ALSchwalm/pISO/pcb/README.md

Designed with [KiCad](http://kicad-pcb.org/)

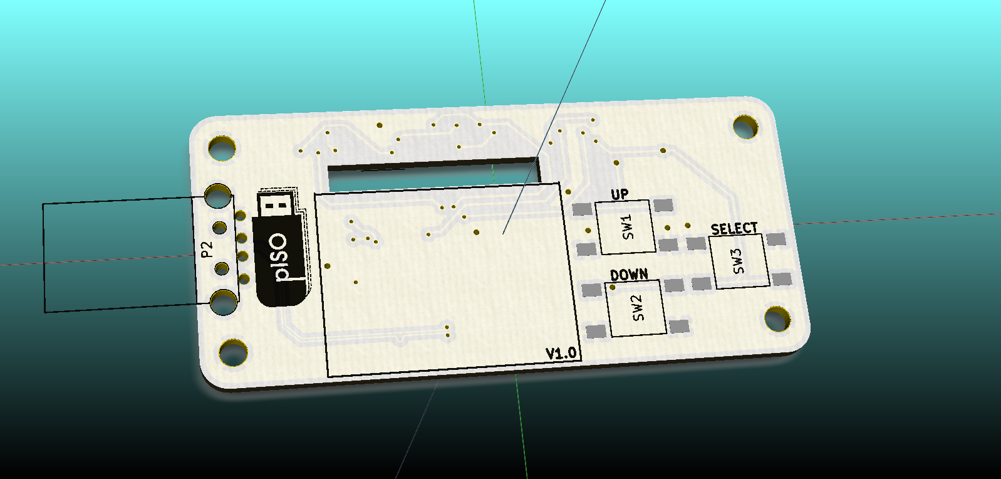
[picture p1: pcb/pHAT/front.png]
front

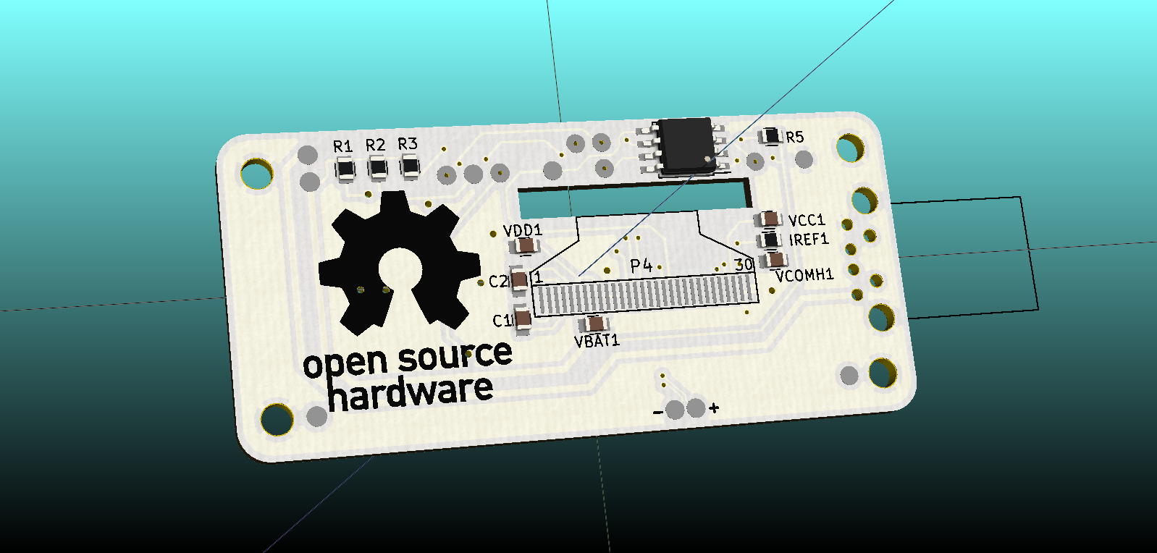
[picture p2: pcb/pHAT/back.png]
back
