ALSchwalm/pISO/pcb/controller_source/readme.txt

Build with atmel studio with -Os

102 chips can be programmed using https://github.com/james-tate/Arduino-TPI-Programmer

25 chips can be programmed over SPI
