ALSchwalm/pISO/assets/create-delete-1.jpg

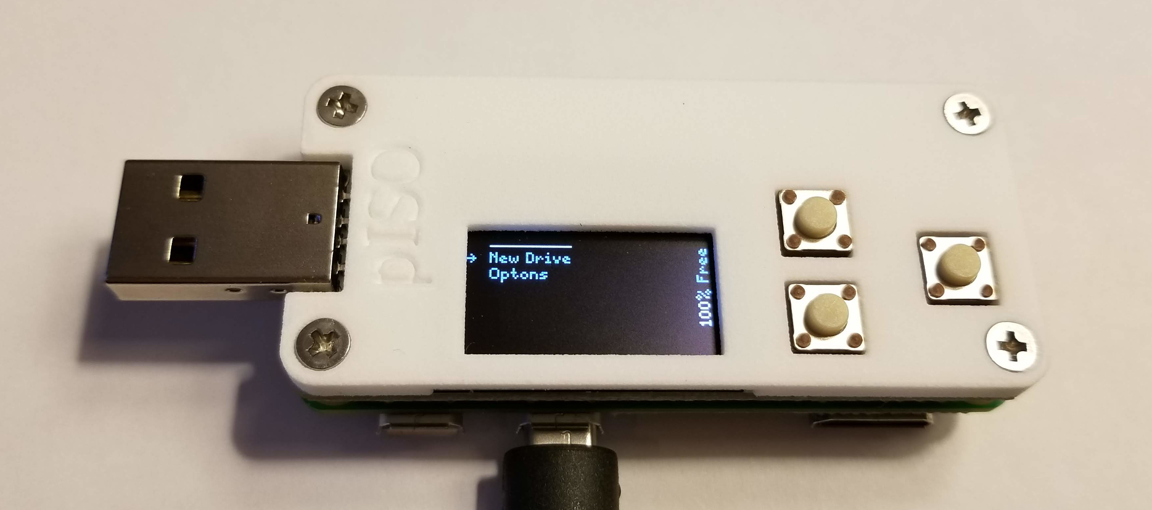
assets/create-delete-1.jpg
