ALSchwalm/pISO/assets/create-delete-2.jpg

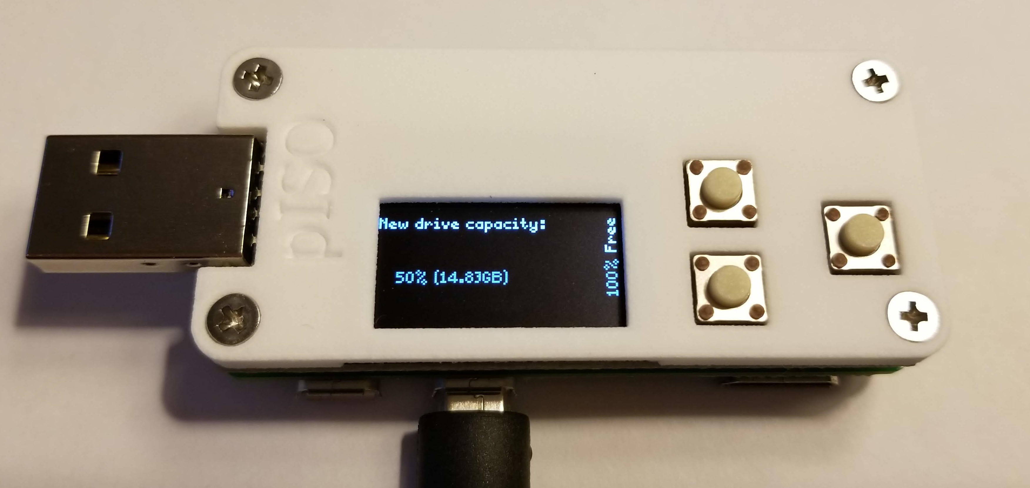
assets/create-delete-2.jpg
