ALSchwalm/pISO/assets/create-delete-3.jpg

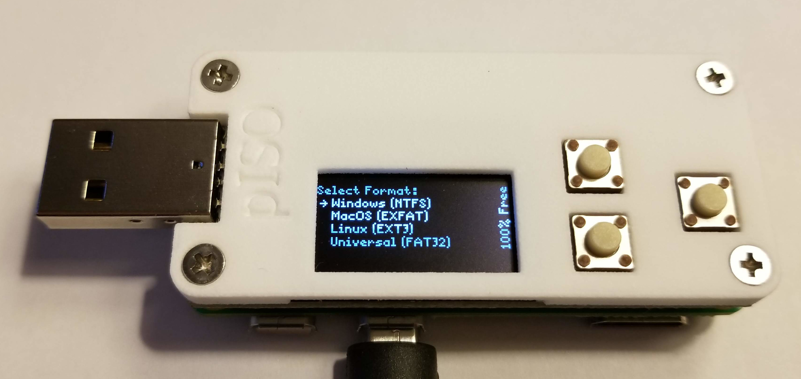
assets/create-delete-3.jpg
