ALSchwalm/pISO/assets/create-delete-5.jpg

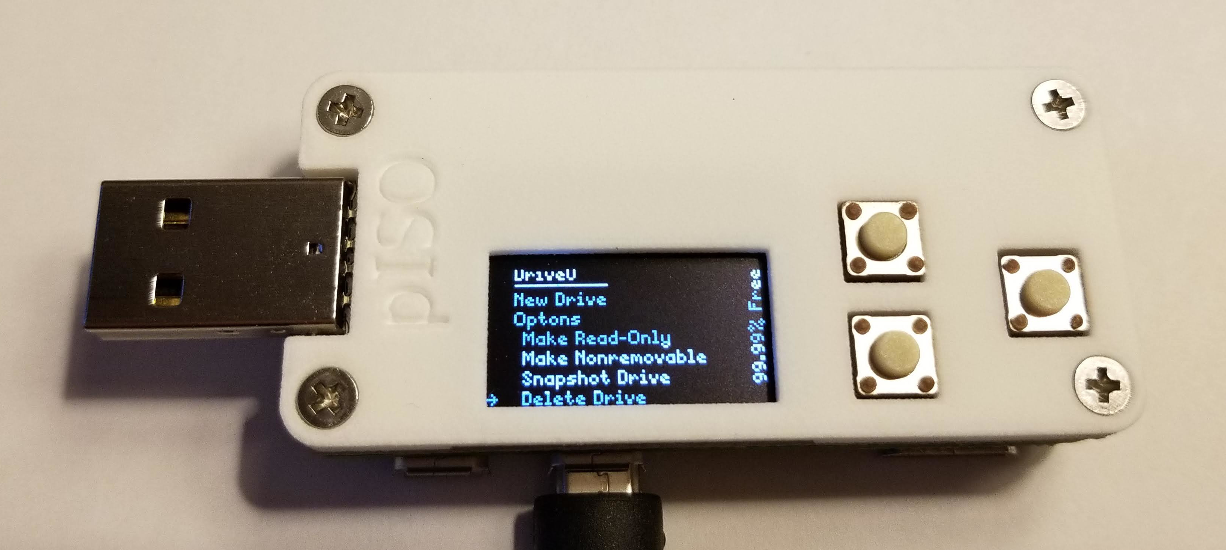
assets/create-delete-5.jpg
