ALSchwalm/pISO/assets/create-delete-6.jpg

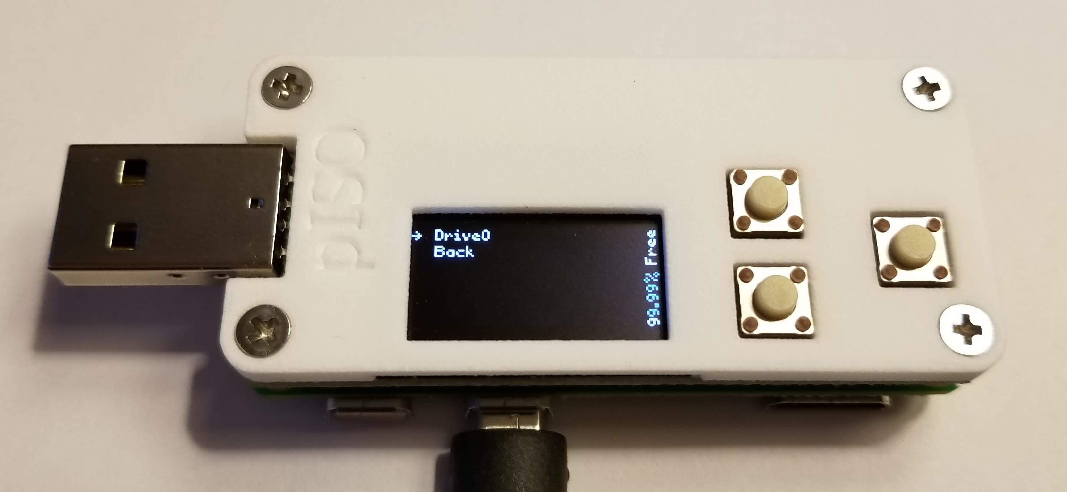
assets/create-delete-6.jpg
