ALSchwalm/pISO/assets/read-only-non-removable-1.jpg

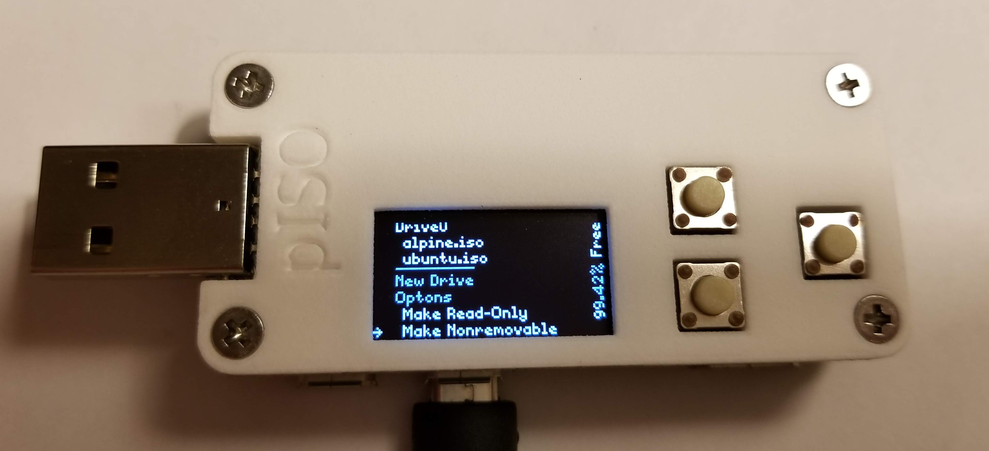
assets/read-only-non-removable-1.jpg
