ALSchwalm/pISO/assets/read-only-non-removable-2.jpg

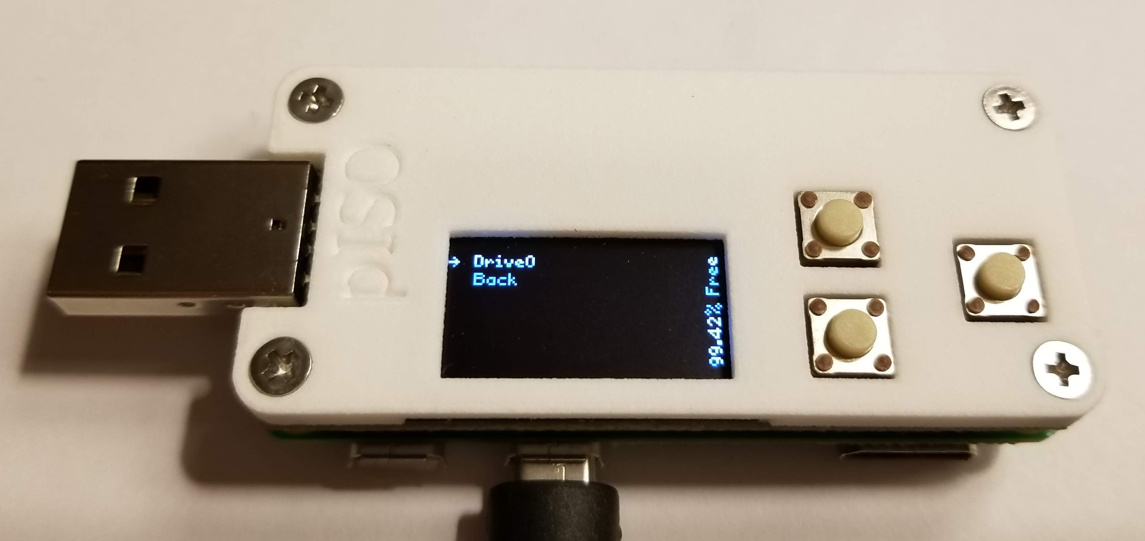
assets/read-only-non-removable-2.jpg
