ALSchwalm/pISO/assets/read-only-non-removable-3.jpg

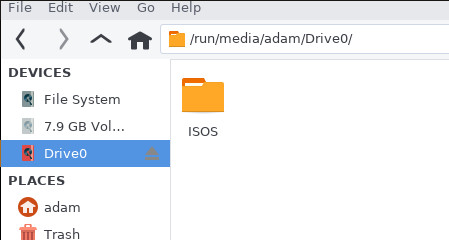
assets/read-only-non-removable-3.jpg
