ALSchwalm/pISO/assets/snapshot-3.jpg

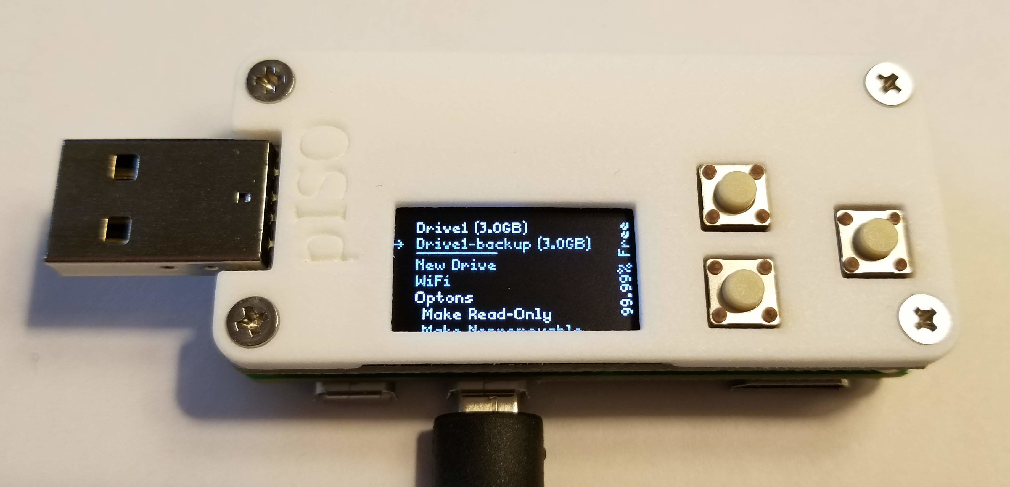
assets/snapshot-3.jpg
