ALSchwalm/pISO/assets/store-and-mount-1.jpg

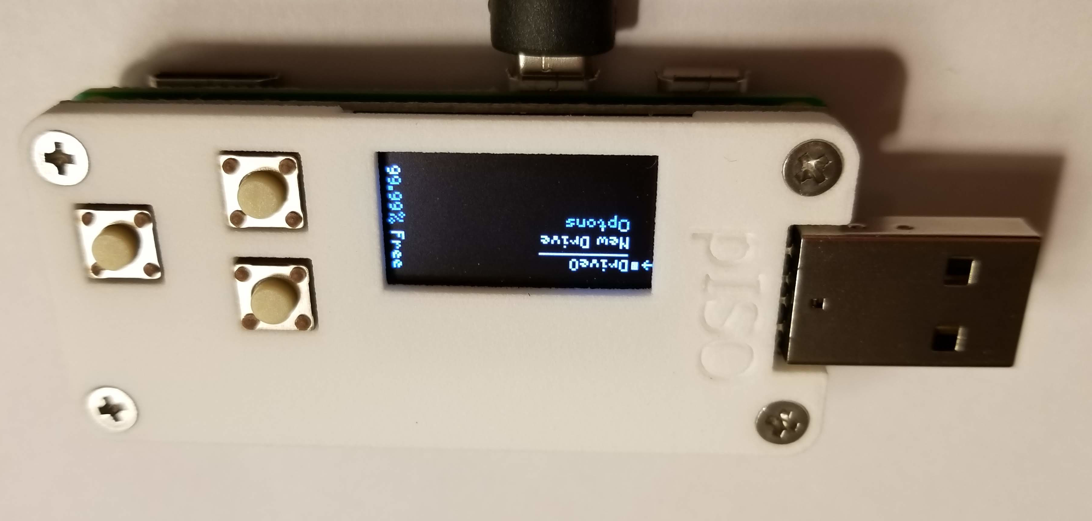
assets/store-and-mount-1.jpg
