ALSchwalm/pISO/assets/store-and-mount-2.jpg

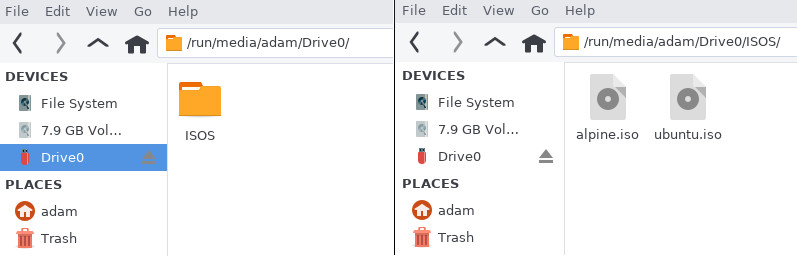
assets/store-and-mount-2.jpg
