ALSchwalm/pISO/assets/store-and-mount-3.jpg

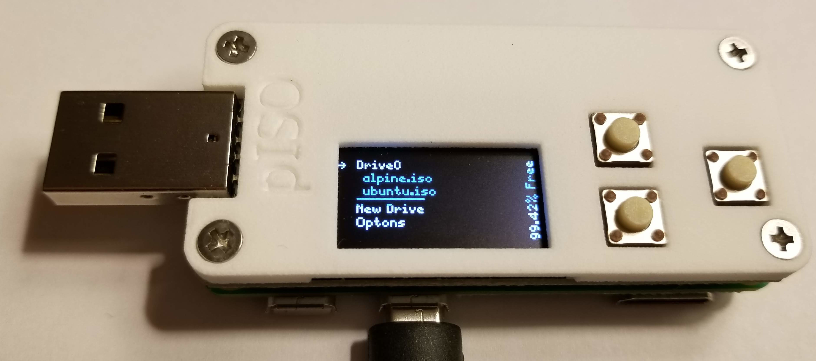
assets/store-and-mount-3.jpg
