ALSchwalm/pISO/assets/store-and-mount-4.jpg

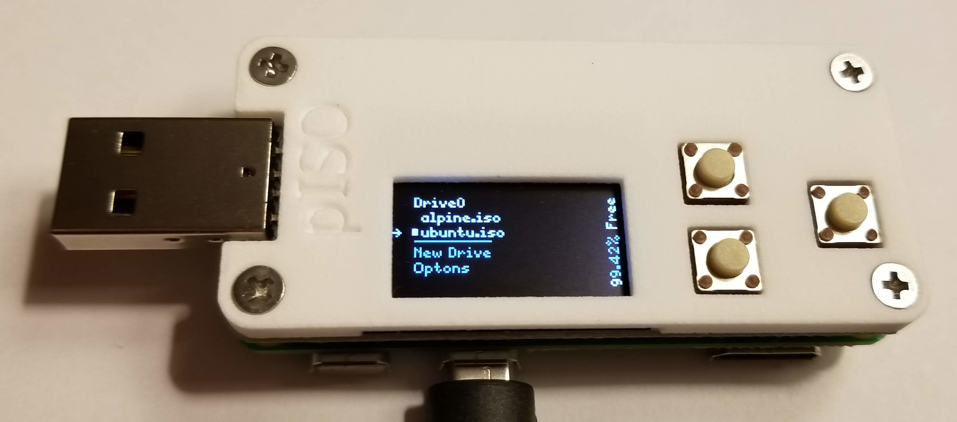
assets/store-and-mount-4.jpg
