ALSchwalm/pISO/assets/store-and-mount-5.jpg

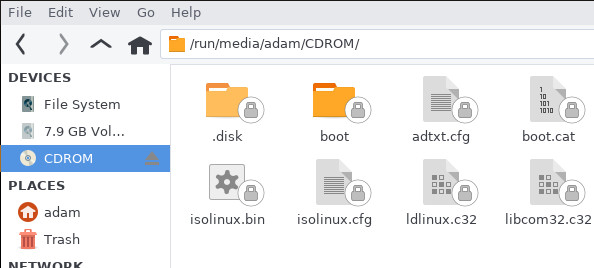
assets/store-and-mount-5.jpg
