ALSchwalm/pISO/assets/wifi-1.jpg

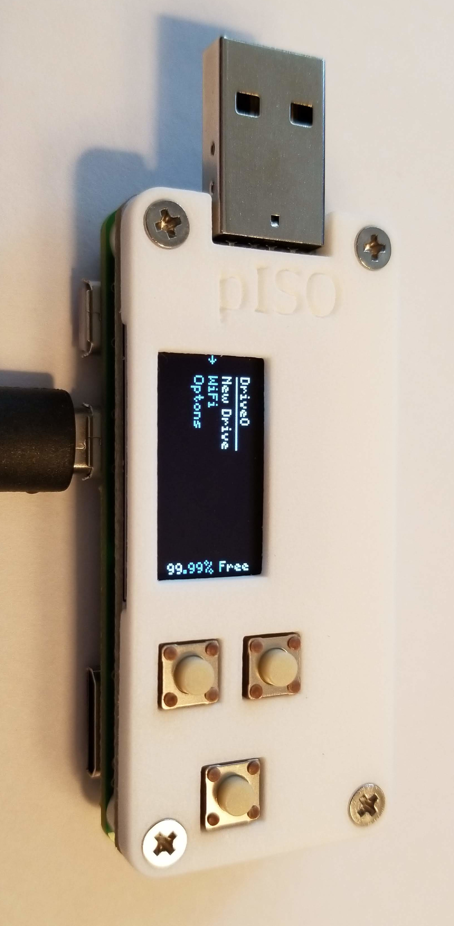
assets/wifi-1.jpg
