ALSchwalm/pISO/assets/wifi-2.jpg

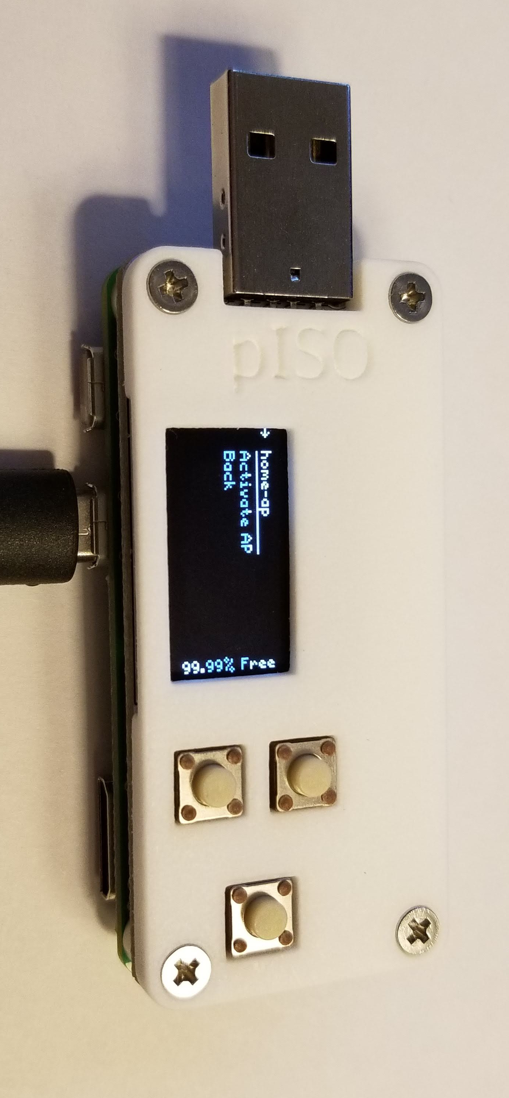
assets/wifi-2.jpg
