ALSchwalm/pISO/assets/wifi-3.jpg

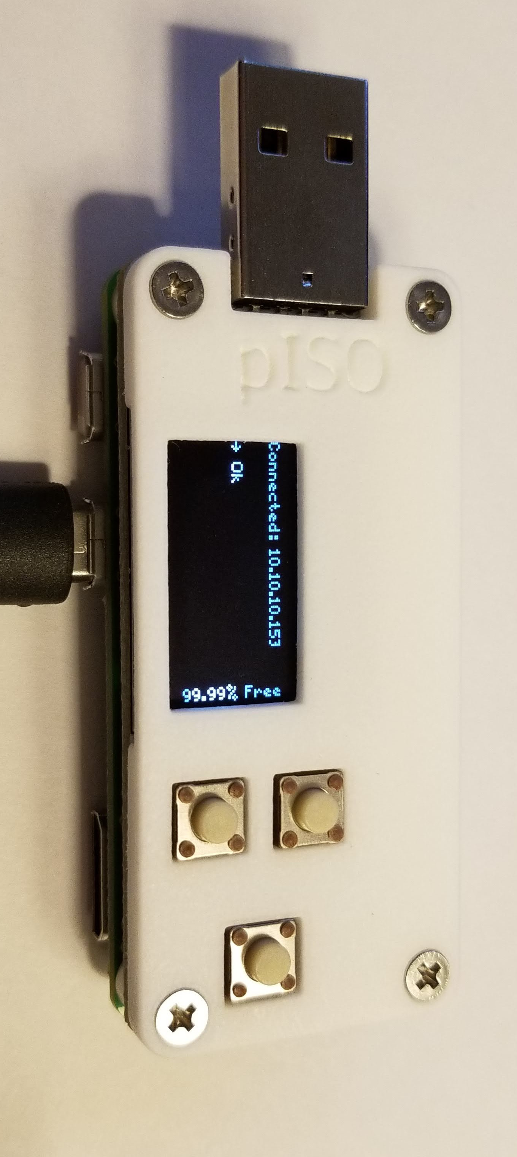
assets/wifi-3.jpg
