ALSchwalm/pISO/assets/wifi-4.jpg

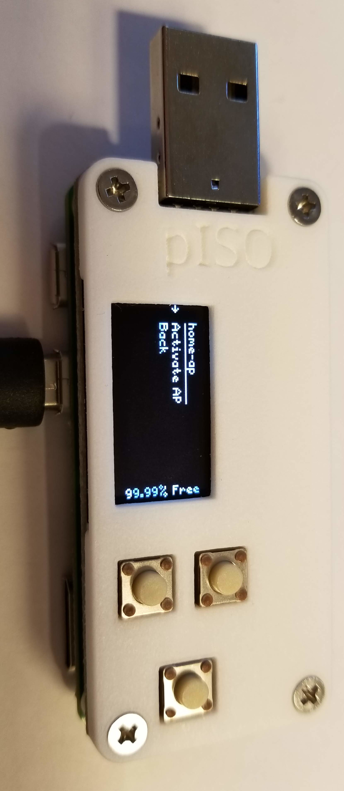
assets/wifi-4.jpg
