ALSchwalm/pISO/pcb/pHAT/BOM/pHAT.xls

Reference | Number Parts | Value | Datasheet
P4 | 1 | CONN_01X30 | http://www.wisechip.com.tw/s/2/product-380039/0-96%E2%80%9D-OLED-Display-UG-2864HLBEG01.html
C1, C2, VBAT1, VDD1, VCOMH1 | 5 | 2.2uF | https://www.digikey.com/product-detail/en/samsung-electro-mechanics/CL21F225ZOFNNNG/1276-6497-1-ND/5958125
VCC1 | 1 | 10uF | https://www.digikey.com/product-detail/en/samsung-electro-mechanics/CL21A106KQCLRNC/1276-2405-1-ND/3890491
IREF1 | 1 | 390R | https://www.digikey.com/product-detail/en/stackpole-electronics-inc/RMCF0805JT390R/RMCF0805JT390RCT-ND/1942549
M1, M2, M3, M4 | 4 | DNP
P2 | 1 | USB_A | https://www.digikey.com/product-detail/en/cui-inc/UP2-AH-1-TH/102-3996-ND/6187911
U1 | 1 | ATTINY25/45/85 | https://www.digikey.com/product-detail/en/microchip-technology/ATTINY25V-10SH/1611-ATTINY25V-10SH-ND/6829774
SW1, SW2, SW3 | 3 | SW_Push | https://www.digikey.com/product-detail/en/c-k/PTS645SM43SMTR92-LFS/CKN9112DKR-ND/1870061
R1, R2, R3, R5 | 4 | 10k | https://www.digikey.com/product-detail/en/stackpole-electronics-inc/RMCF0805JT10K0/RMCF0805JT10K0CT-ND/1942577
W1, W2, W5, W7, W8, W9, W10, W11, W12, W13, W14, W15, NO1, A1, B2 | 15 | POGO | https://www.digikey.com/product-detail/en/preci-dip/90173-AS/1212-1881-ND/5451904
 | 32
