ALSchwalm/pISO/assets/assemble-with-cover-1.jpg

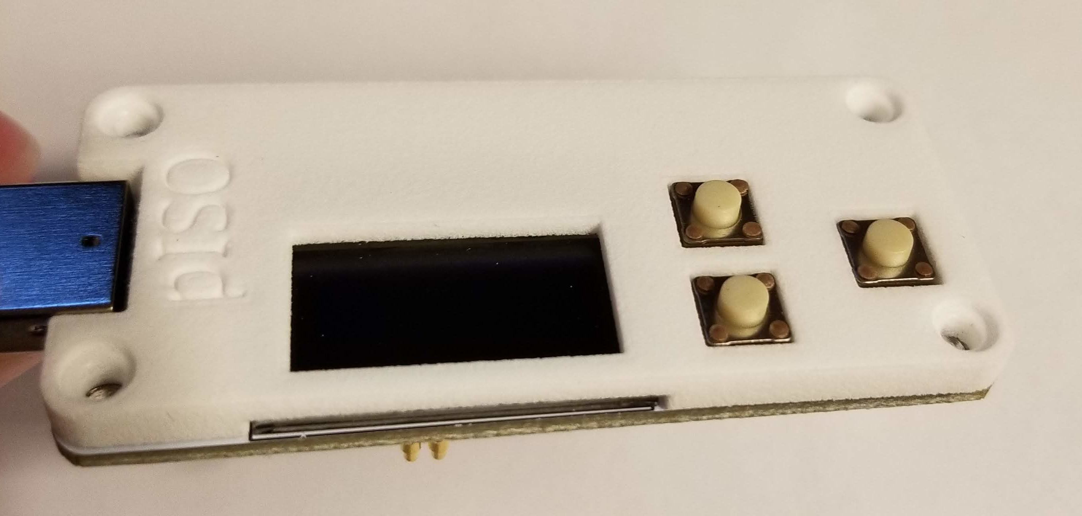
assets/assemble-with-cover-1.jpg
