ALSchwalm/pISO/assets/assemble-with-cover-2.jpg

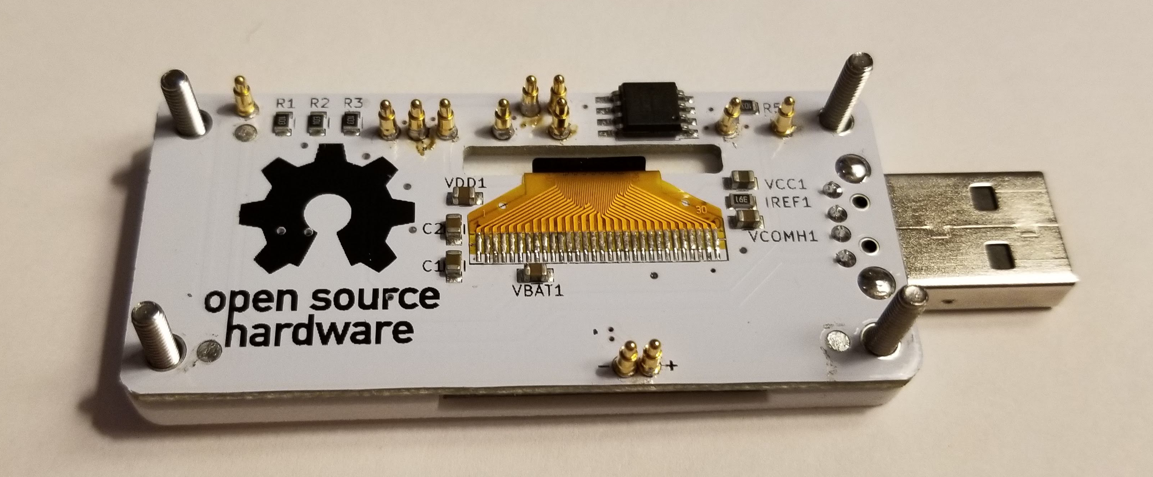
assets/assemble-with-cover-2.jpg
