ALSchwalm/pISO/assets/assemble-with-cover-3.jpg

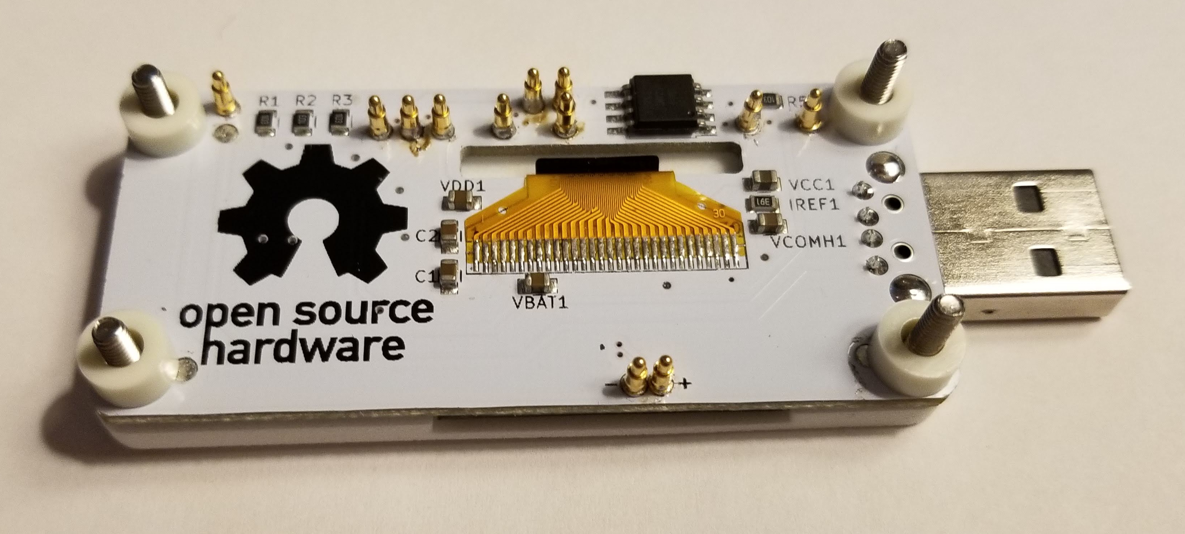
assets/assemble-with-cover-3.jpg
