ALSchwalm/pISO/assets/assemble-with-cover-4.jpg

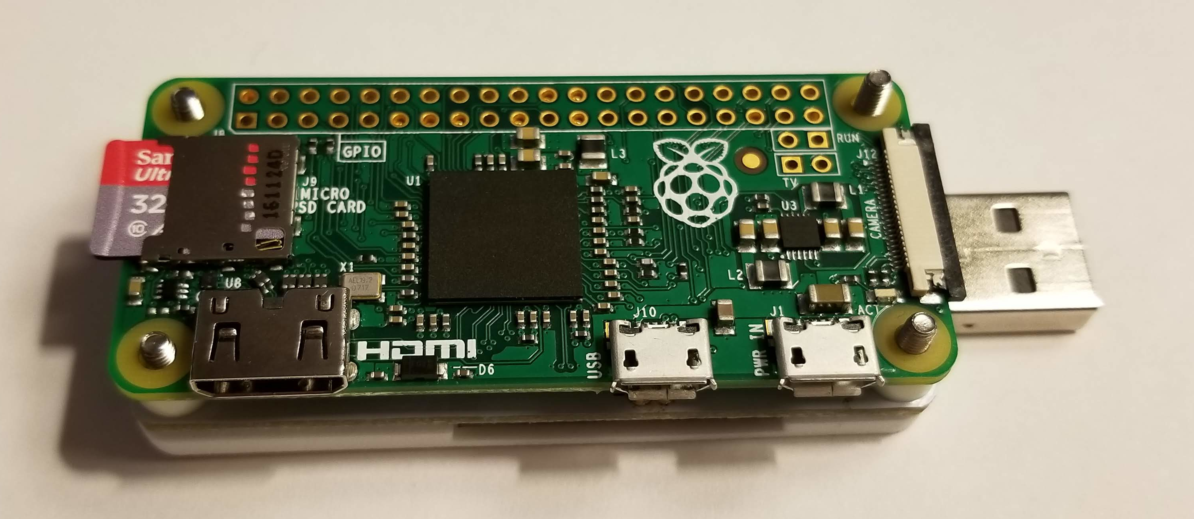
assets/assemble-with-cover-4.jpg
