ALSchwalm/pISO/assets/assemble-with-cover-5.jpg

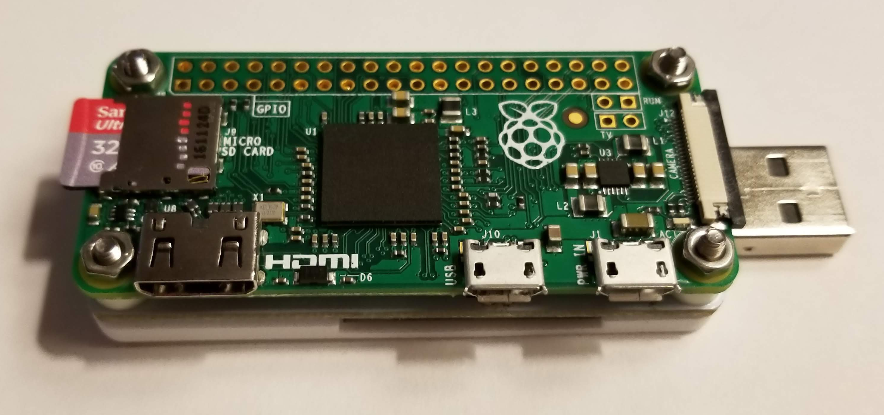
assets/assemble-with-cover-5.jpg
