ALSchwalm/pISO/assets/assemble-with-cover-6.jpg

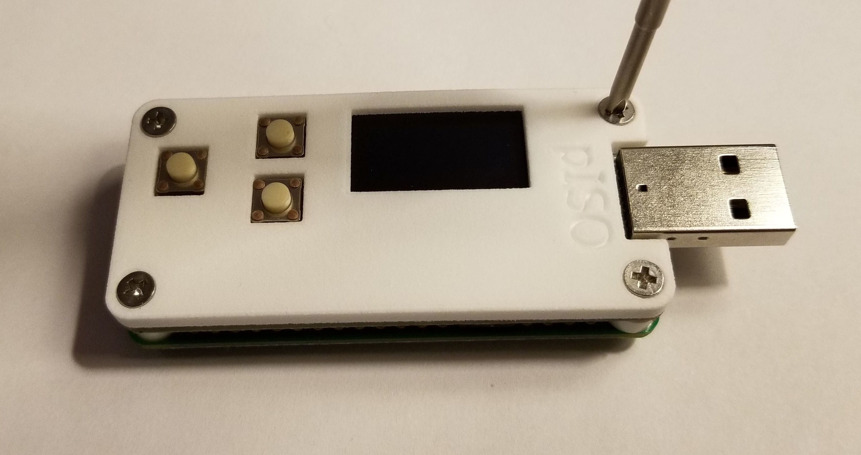
assets/assemble-with-cover-6.jpg
