ALSchwalm/pISO/assets/assemble-without-cover-1.jpg

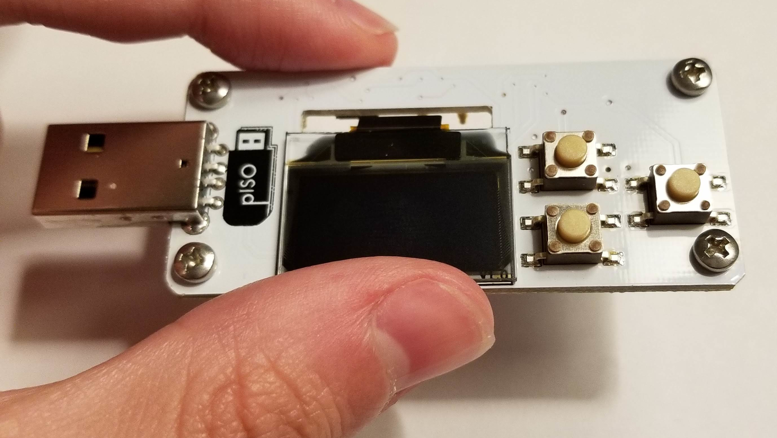
assets/assemble-without-cover-1.jpg
