ALSchwalm/pISO/assets/assemble-without-cover-2.jpg

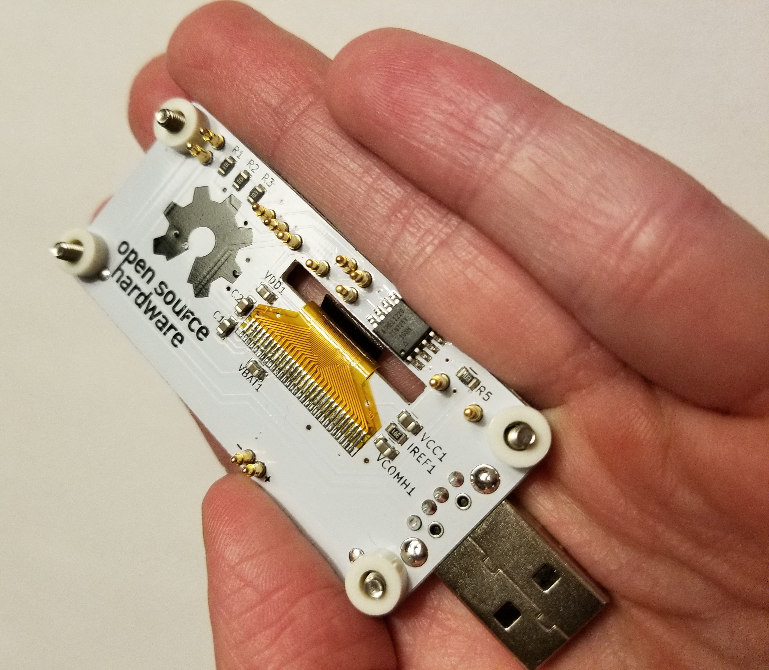
assets/assemble-without-cover-2.jpg
