ALSchwalm/pISO/assets/assemble-without-cover-3.jpg

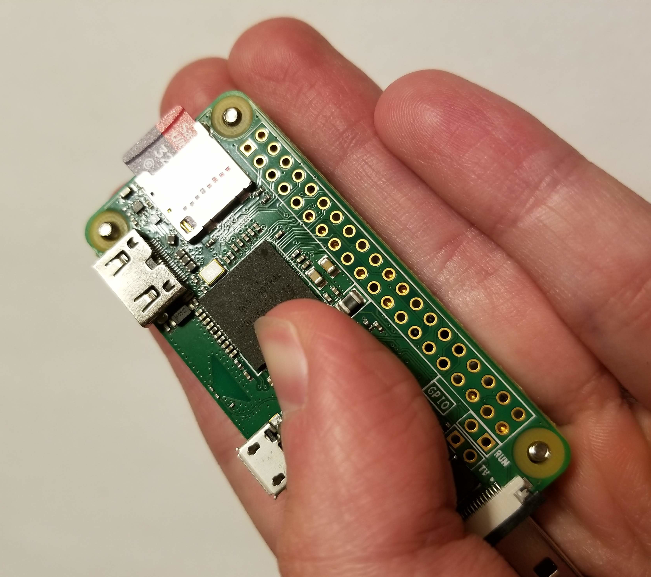
assets/assemble-without-cover-3.jpg
