ALSchwalm/pISO/assets/assemble-without-cover-4.jpg

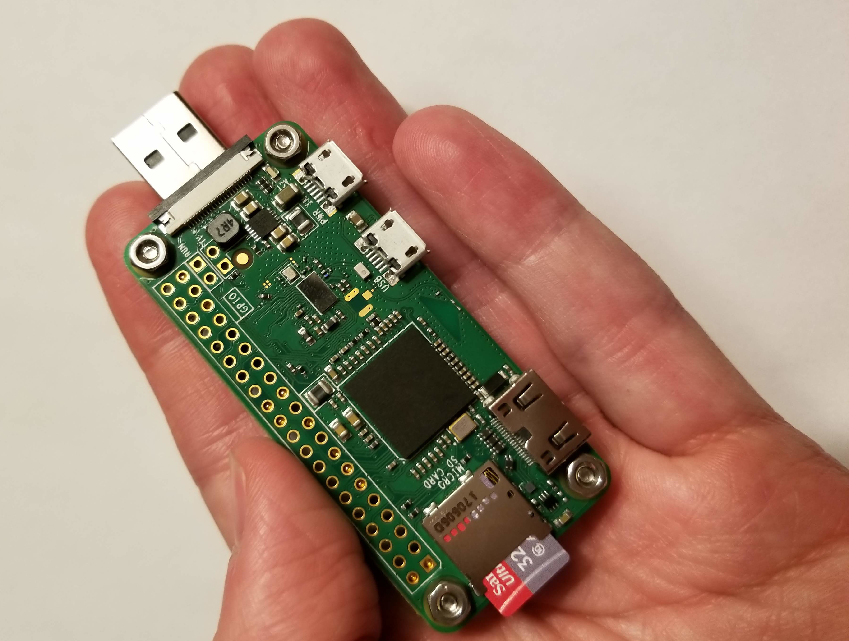
assets/assemble-without-cover-4.jpg
