ALSchwalm/pISO/assets/assemble-without-cover-5.jpg

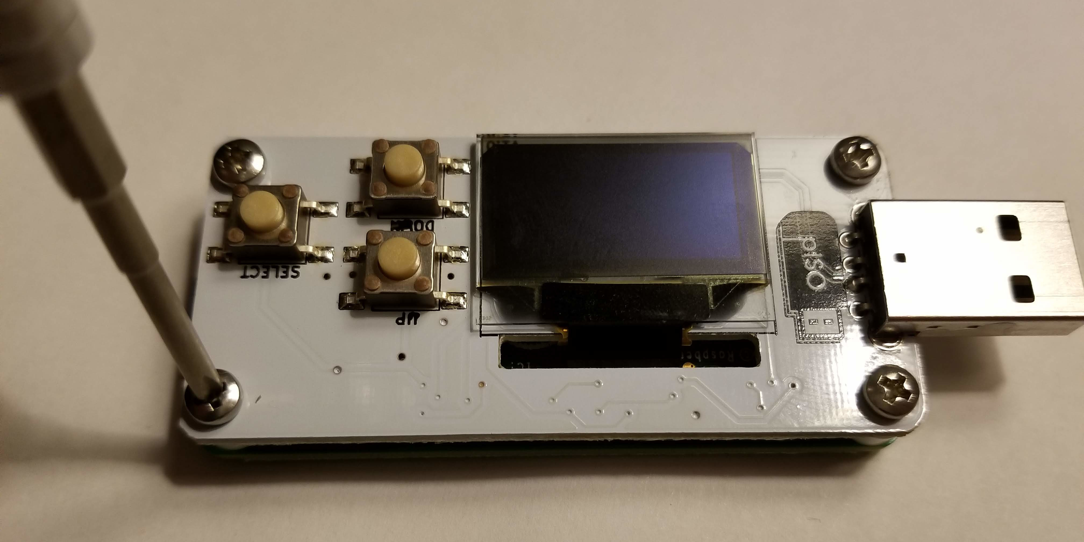
assets/assemble-without-cover-5.jpg
