ALSchwalm/pISO/assets/install-1.png

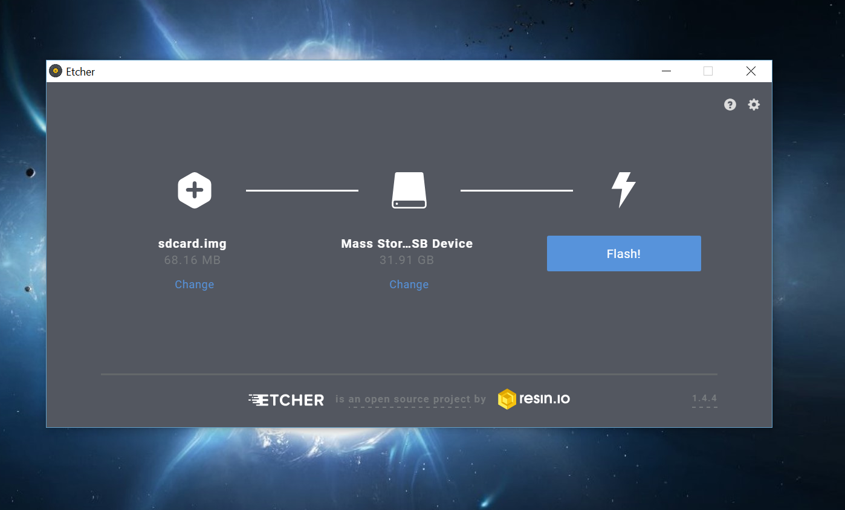
assets/install-1.png
