ALSchwalm/pISO/assets/install-2.png

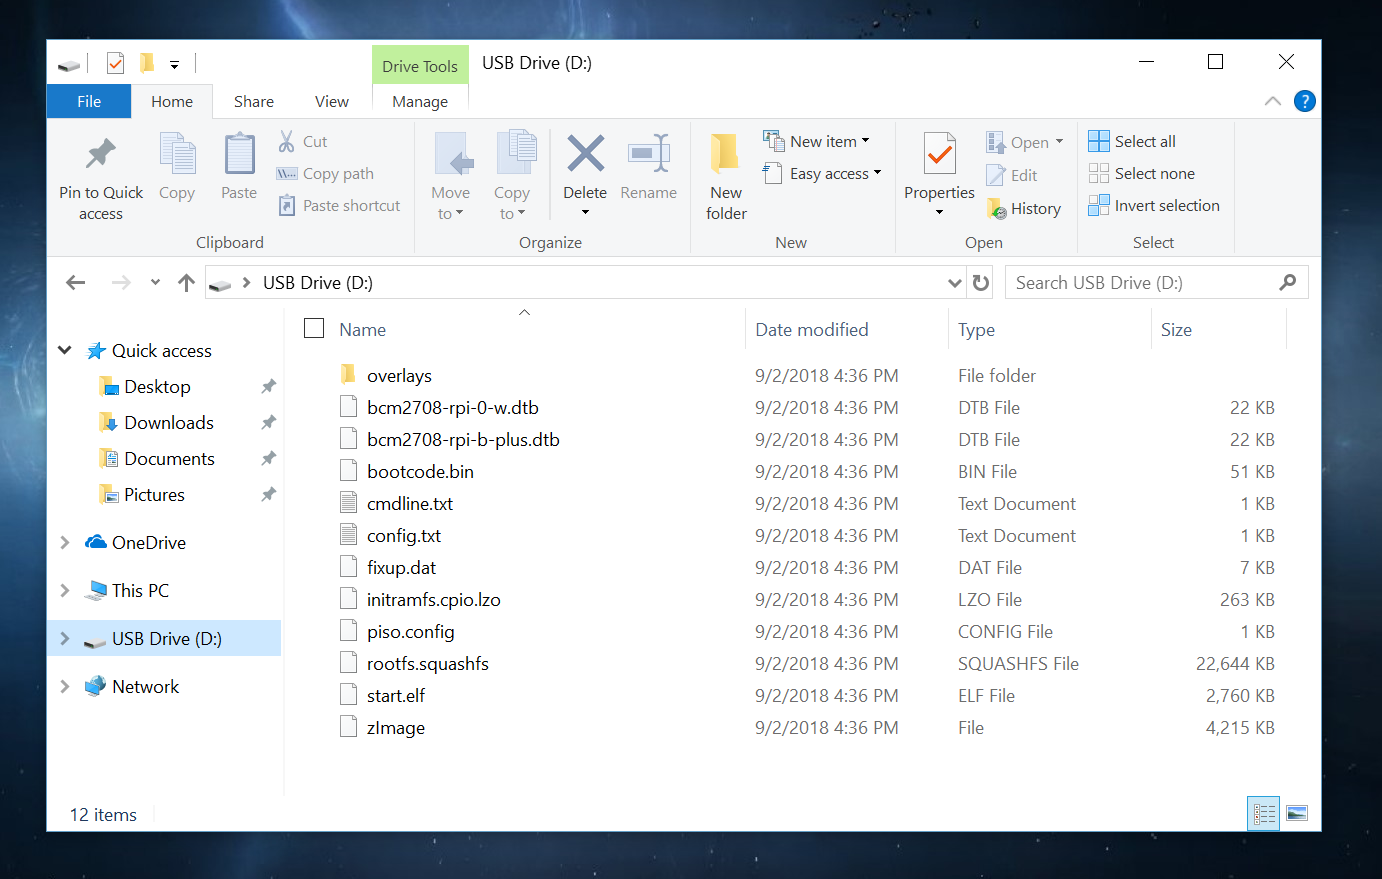
assets/install-2.png
