ALSchwalm/pISO/(threads)

Thread 1 (2017-11-20):

Get valid USB device/vendor ID

ALSchwalm, 2017-11-20:
http://pid.codes/howto/

ALSchwalm, 2018-04-27:
Made PR here: https://github.com/pidcodes/pidcodes.github.com/pull/321

ALSchwalm, 2018-05-08:
Closed via 6ae9c29b

Closed 2018-05-08.

Thread 6 (2018-03-27):

Make use of wifi/bluetooth for Pi Zero W

ALSchwalm, 2018-03-27:
Currently, I think the best approach is to just allow the pi to act as an FTP server for vdrives that have been internally mounted. Wifi connect should take the following approach:

1. Attempt to connect to a pre-configured network for some time interval (say, 20 seconds)
2. After a timeout, create a wireless AP to allow the user to connect to (or maybe just have a button to let the user choose when this should be active)

We could potentially use bluetooth to get keying info for do encrypted drives, but this would probably require creating an Android and IOS app which is probably not feasible prior to launch.

ALSchwalm, 2018-05-23:
This is pretty much finished at this point. Some work remains to be done with SMB, but I'm gonna go ahead and close this.

Closed 2018-05-23.

Thread 7 (2018-03-27):

Verification

ALSchwalm, 2018-03-27:
Some interest has been expressed in having an optional verification step for isos. This probably wouldn't be that hard to implement, if we just say for each iso, you can have a 'iso.hash' file. If the hash is present, then long-pressing the select button on mount the iso after checking the hash.

ALSchwalm, 2018-09-02:
It is unlike we will ship with this, so I'm going to close it. If there is sufficient interest, I'll reopen.

Closed 2018-09-02.

Thread 18 (2018-06-15):

Better input logic

ALSchwalm, 2018-06-15:
Currently, input feels a bit laggy, and we sometimes drop inputs. This can almost certainly be fixed by changing things around a bit in controller.rs.

ALSchwalm, 2018-09-03:
This is essentially fixed via 0677390e5265939f63327e1a546167af9ef2d3bd

Closed 2018-09-03.

Thread 22 (2018-09-02):

Better error screen

ALSchwalm, 2018-09-02:
Currently, the error screen does not tell users how to actually report the issue. It should link to something like 'https://piso.support/issue' which would redirect to the wiki page on reporting issues.

ALSchwalm, 2018-09-02:
Fixed in 0c506cdc3b805cb321821cd23d6728242c9d44b6

Closed 2018-09-02.

Thread 23 (2018-09-02):

Add config option to log to peristent storage

ALSchwalm, 2018-09-02:
For performance reasons, we don't write the log file to the sd card. This is typically fine because when an error occurs, we will copy the log file in to the debug tar file. However, if pISO just hangs for some reason, there will be no way for us to debug the issue.

We should probably have a way to configure debugging to the sd card. That way we should be able to track down the issue if it is reproducible.

ALSchwalm, 2018-09-17:
Fixed by alschwalm/buildroot@e17742211cf13ff05e19b0a0ecf5459487c0ce58

Closed 2018-09-17.

Thread 25 (2018-09-05):

Ensure that a sd card can be flashed multiple times

ALSchwalm, 2018-09-05:
Currently, the flash procedure can cause strange things to happen if a drive has already been flashed once. We should probably prevent that.

BigTexun, 2018-10-08:
I found this the hard way...  IF the filesystem is something Windows supports, etcher works fine.  If the filesytstem is a previous RP filesystem, etcher will corrupt the partition table.  No Windows based tool can correct this condition, the partition causes partition tools to lock up in Windows.  I was able to resolve this by using GParted.iso.  GParted boots into a linux kernel and has no trouble working with the partition table that locks up Windows.

Windows CAN delete Linux partitions in general, so I'm not sure why Etcher has a problem.  Etcher reports that it is using the diskpart command line, but I have not dug into what it is doing wrong.

Running diskpart, selecting the drive and issuing the clean command generates a "cannot find file" error, but  successfully wipes out the linux partitions, allowing etcher to run successfully.  It seems Etcher is running the /wrong/ diskpart command line for a flash devices with linux partitions.

BigTexun, 2018-10-08:
If I run etcher first, diskpart's "clean" function cannot work.  You MUST run diskpart's clean function before running etcher.  Once you have corrupted the partition table with etcher, you must be running linux to repair/clean the drive...  At least that is what I found.

I spent time resolving this last weekend, and today I was able to recreate the problem.  So even if I have some details wrong, I can recreate the issue, the corruption, and the two work-arounds I have tested.

Thread 27 (2018-09-16):

'Universal' drive format should be FAT32

ALSchwalm, 2018-09-16:
This is currently exfat

ALSchwalm, 2018-09-17:
Fixed in caacf0c89ddfe8fe05291473fdccc65d36bd94f1

Closed 2018-09-17.

Thread 30 (2018-09-29):

Naming Drives

clreinki, 2018-09-29:
I really wish we could name each drive - even if it's limited to like 8 characters.  Something to better remember which drive is which.

kdallasd, 2018-10-01:
Something as simple as a text file in the root of each partition (like name.txt) that could be read (like how the ISOs currently are) would be nice. Actually inputting one via the piso would be a pain

ALSchwalm, 2018-10-02:
The trouble with using a text file on each virtual drive is that we would need to mount the drive 'internally' so the pISO can read it before we 'export' the drive so the host computer can see it. This would slow things down and potentially create issues when the user is trying to boot from an ISO.

One possible solution here is to add a section to the `piso.config` file that allows the user to provide a different name. Something like this might work:

```
[[drive]]
name="Drive1"
rename="My Drive Name"
```

This could also be useful if I end up adding other drive-specific options.

clreinki, 2018-10-02:
I like your proposed idea, Adam.

Thread 31 (2018-09-30):

Support force-creating debug dumps

ALSchwalm, 2018-09-30:
Debugging some issues with mounting drives would be much easier if we could get a debug log even when no explicit error has occurred. This can probably just go under the 'Options' menu.

Thread 32 (2018-10-01):

Trouble Mounting ISOS

codybuell, 2018-10-01:
I'm able to create and use drives just fine, however when trying to mount ISO's I get the error:

> The disk you inserted was not readable by this computer.

Working on OSX Mojave.  Have tried mounting ISOs with from EXFAT and FAT32 drives.  Believe I'm working with pISO v1.0.1.

ALSchwalm, 2018-10-02:
I am not sure why you're experiencing this issue. I have not updated to Mojave yet, but I will do so soon and see if I can recreate the problem. Thanks fo the feedback! I will get the issue resolved as soon as possible.

compukidmike, 2018-10-02:
I'm having the same issue on macOS Sierra (10.12.6), using piso v1.0.2

yllwfsh, 2018-10-07:
@codybuell What kind of file system is on the .ISO file? Can macOS mount anything from it when double clicking the iso file? I noticed that macOS is generally unable to mount Linux based .iso files, so this would be expected behaviour...

codybuell, 2018-10-07:
@yllwfsh They are linux iso's.  It was my understanding that the piso does not try to mount the iso on the host OS's filesystem but rather mounts itself internally and presents it to the host as a virtual CD drive.

yllwfsh, 2018-10-07:
@codybuell I'm not exactly sure how pISO mounts the .iso files, maybe @ALSchwalm can elaborate. I do know that under Linux (Debian/Ubuntu) all the ISO's mount fine, and PC's can also boot from them.

ALSchwalm, 2018-10-08:
Sorry for the slow start on this. I have confirmed the issue, though I'm not really sure what's causing it. It is next up on the list for me to work on after #35.

joedemo42, 2018-10-10:
FWIW I verified this issue with an ISO directly from Microsoft: Win10_1803_German_x64.iso - also this happens with FreeBSD-11.2-RELEASE-amd64-bootonly.iso or really any other ISO. As for the Win10 ISO I'm able to mount it just fine on macOS 10.13.6

ALSchwalm, 2018-10-16:
I would like to track this issue down next for a '1.3.0' release, but I think I am going to need a little help from someone. My MacBook is USB-C only, which is making it difficult to debug this kind of issue. If anyone has a MacBook with a standard USB port (that is, one where you can plug the pISO in without an adapter of any kind), and is willing to help debug, please let me know. You will also need to be running High Sierra or newer for this debugging.

Thanks in advance to any volunteers!

joedemo42, 2018-10-16:
I could do that. I‘ve got a 2012 MacBook Air running High Sierra.

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

ALSchwalm, 2018-10-16:
@joedemo42 Great! Here is the procedure:

1. Install [Wireshark](https://www.wireshark.org/)
2. From the terminal, run 'sudo ifconfig XHC20 up' (this enables capturing the USB traffic)
3. Open wireshark. You should see an 'XHC20' interface
4. Double click this interface to start the capture.
5. Insert the pISO and select an ISO
6. When the error message is displayed saying the disk is not readable by the computer, press the red stop button to stop the capture.
7. 'File->save as' and save the capture somewhere
8. Send the capture to 'usb@piso.support'

Thanks for your help! And please let me know if you have any questions or run in to any issues.

yllwfsh, 2018-10-16:
@ALSchwalm I'll also chip in with some packet captures. Sending you an email shortly.

joedemo42, 2018-10-16:
pcapfile was sent.

ALSchwalm, 2018-10-17:
Big thanks to everyone who helped out with the captures! I'm not exactly sure what this issue is here (though I suspect is has something to do with the MODE SENSE implementation). However, Wireshark apparently cannot correctly parse USB packets captured on a Mac, so I'll need to fix that first before I can really diagnose the issue here.

yllwfsh, 2018-10-17:
@ALSchwalm Maybe the issue is with wireshark? I'll try a Nightly build tonight (
https://www.wireshark.org/download/automated/osx/Wireshark%202.9.0-2227-g3d6bf1fe%20Intel%2064.dmg) Maybe that helps. What kind of packets (e.g. your packet filter) are you looking for? Then I can check if it's working properly or not...

ALSchwalm, 2018-10-22:
Just to keep people in the loop on this. I have not tracked down the exact issue, but I have patched wireshark so it can read USB captures made on MacOS correctly. For anyone interested I have attached the patch (it applies to wireshark as of wireshark/wireshark@7ca5dba864391807c50b8a843886b1131563f1fb): [wireshark.patch](https://github.com/ALSchwalm/pISO/files/2503744/wireshark.patch.txt)

I should be able to track things down now. Currently, it looks like the problem is that MacOS is issuing CD READ instead of standard READ commands, but it will take a bit more digging to be sure.

ALSchwalm, 2018-10-30:
This should be fixed in the latest v1.3.0-beta.1 release.

yllwfsh, 2018-11-04:
Some ISO's will load correctly under macOS now. Some don't, but I suspect that's not pISO's fault, but more because they are Linux/Unix/BSD specific iso's, e.g.:

Working:
Win10_1803_English_x64.iso
proxmox-ve_5.1-3.iso

Not Working: (The actual .iso file doesn't load on macOS either when double clicking, 'no mountable filesystems')
FreeNAS-11.2-BETA3.iso
gparted-live-0.32.iso
pop-os_18.04_amd64_nvidia_36.iso
xcp-ng-7.5.0-2.iso
elementaryos-5.0-beta2.20180920.iso

Is there any trick that you could think of with pISO to be able to mount these under macOS? Or is this simply a limitation of macOS itself?

Thread 33 (2018-10-01):

Not able to boot from ISO files

lorddaveron, 2018-10-01:
I've created the ISOS folder and copied over a Windows 8 iso, Ubuntu Desktop iso and Ubuntu Server ISO.  I've followed the guide and activated the iso and when plugged into a running windows 10 OS I see the CD rom mount and the files come up.  But if I try to boot from PISO,  the computer doesn't see the image as a boot up option.  I've tried two different computers and several different BIOS settings.  I don't have a PISO error dump since there was no error.  It just won't recognize as a bootable device. I set the drive up as fat when I first provisioned it.  Shouldn't the PISO support this?

ALSchwalm, 2018-10-02:
I suspect the issue you're having is related to boot timing. There is a race when the computer starts up, if the BIOS polls USB devices before the pISO has started, then it will miss the virtual CD drive that the pISO creates and not show it as a boot option. There are two ways to get around this. The easiest is just to leave the pISO plugged in and soft-reset the machine (typically via something like ctrl-alt-delete from your BIOS screen). On most machines, this will leave the power to USB peripherals active but start the startup sequence again. On this second bootup, the pISO is already started, so it will be read by the BIOS and the boot option will be displayed.

The other option is to power the pISO via the micro usb ports. If you power the pISO via, for example, a microUSB phone charger, and plug it in to the machine, then it will already be booted when the machine checks for USB devices.

Please let me know if doing either of those resolves your issue or if you have any other questions.

ukscone, 2018-10-02:
>The other option is to power the pISO via the micro usb ports. If you power the pISO via, for example, a >microUSB phone charger, and plug it in to the machine, then it will already be booted when the machine >checks for USB devices.

I have been asking around about this as it seems like it could be slightly dangerous to the pizero or the computers usb slot as there would be power coming to the pi from two sources. I haven't tried it as i'm a teeny bit "scared" but if you say it'll be fine then i'll give it a go

ALSchwalm, 2018-10-02:
@ukscone You are correct, I asked @james-tate (the hardware designer for the pISO) and he confirmed it was not a good idea. I have edited my answer above accordingly.

lorddaveron, 2018-10-02:
I've tried powering the pISO with a USB charger and then booting the PC,
I've also tried setting up the .iso while the machine was on,  seeing the
drive pop up in windows and rebooting the machine.  The screen on the pISO
shows that the image is mounted,  but the bios does not see any bootable
device.  Powered versus un-powered doesn't seem to make a difference.

On Mon, Oct 1, 2018 at 11:30 PM Adam Schwalm <notifications@github.com>
wrote:

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

james-tate, 2018-10-03:
@lorddaveron Can you let me know the type of machine are you using so I can do some research on this?

ALSchwalm, 2018-10-03:
@lorddaveron Is it possible for you to confirm that the device supports booting from a normal USB CD drive? This is essentially what the pISO is emulating, so if it is not supported by your device, that would cause problems.

lorddaveron, 2018-10-03:
I've tried on a couple of different machines.

Dell Latitude E7450
Dell Optiplex 990
Custom Desktop with MSI Z87-G45 Motherboard

On Tue, Oct 2, 2018 at 9:10 PM Adam Schwalm <notifications@github.com>
wrote:

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

jact10, 2018-10-03:
having almost the same problem, but i can boot with linux isos stop in the first step saying that the cd is damage or currupt data, i try with 5 diferent micro sd card and different ISO image and having the same problem

GunnarSpawn, 2018-10-06:
I'm seemingly getting stuck for every linux iso I've used 32 bit or 64x on the "Failed to detect or get files from CD/Rom".
Verifying the device works fine but then trying to get the content from the cd/rom fails everytime. When I boot from the linux cd gadget it seems to fail to mount any drive that either the piso or machine could use as a valid hard disc for installation.

I've tried Centos and a ParrotOS Debian based iso and no go. I also cannot mount the cd roms dir from shell to a folder to try to load it from the installer.

GunnarSpawn, 2018-10-06:
Update:
What I have found works to bypass this issue is. Instead of loading the iso's from the ISOS folder withing the Virtual drives the Piso creates. I have found instead using the virtual drive and writing the operating system ISO to the virtual drive work better then the ISOS folder for the moment. Not too big a deal for me, so basically if you created several virtual drives then wrote ISOS to each of them, thats a compromise for now. The issue I was ultimately having was linux ISOS would fail to fully load files from the iso and upon boot loads a bunch of failed to mount errors. Using it this way you still may notice mount errors however you can load into live mode from your Virtual disc partitioned linux iso installer as well the installer just fine oddly enough.

#NOTE# Picture 1 is an example of my virtual drive 2 being formatted to run as a ParrotOS debian ISO installer usb /drive. Drive1 using ISOS folder doesn't load as well as this method for some reason.

#Picture 1#
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

#Note# Picture 2 is an example during installation of the partition manager to just show what I was working with and how it could potentially show up as being mounted.
#Picture 2#
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

#Note# Picture 3 is an example of live image being ran from the virtual drive successfully vs Drive1 ISOS method.
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

Hope this helps anyone for the time being. I used win32discimager for the iso - virtual drive and I had it formatted under fat32.

Drive1 even being under fat32 wasn't able to load fully / properly from "Cd/rom" during installer and would fail to continue.

ALSchwalm, 2018-10-08:
@GunnarSpawn I believe the issue you and @jact10 are running in to should be fixed during the next release (at least for linux isos). I'm currently holding off on doing that release until I can get a fix in for #35 (or if I determine that will take longer than I thought). Hopefully I'll get it out in the next few days, though.

GunnarSpawn, 2018-10-08:
I can try to get you a better screenshot / log from the PISO if you like. It seemingly has troubles mounting directories / drives so I presume its also unable to fetch the files from the appropriate virtual drives iso / currently mounted one. Thank you for all your work with this @ALSchwalm I've been having an absolute blast messing around with it haha.

Even doing it this way for the moment is fine I can just use several virtual drives formatted correctly to the distro / os used and just write the isos to them using win32discimager / akin. Then it seems to be a little better when selecting that drive and using that to boot per my example the other day.

I've basically got 3 drives at the moment 1 for isos / usb storage, second for windows ISO testing which I also encountered the driver error (using the ISOS folder method), and thirdly the one from my example; a virtual drive with iso installed onto it versus housed within a ISOS folder.

I've been absolutely loving the copying speeds from wifi versus physical so if anyone is having troubles with it taking a long / obscene amount of time. I shaved a few minutes using the wireless AP and ftp'ing to it.

teemusaila, 2018-10-10:
Booting does not work either with Lenovo W510. Tried with both methods, ISO and bootable USB drive.
Bios recognises the drive and starts to boot, but after a while it crashes without any message and boots from local HDD. Very same ISO's are bootable with Yumi on regular USB drive.

ALSchwalm, 2018-10-10:
This issues many users in this thread are experiencing may be fixed with the latest beta: [available here](https://github.com/ALSchwalm/pISO/releases/tag/v1.1.0-beta.1)

jact10, 2018-10-10:
My problem was solved with the BETA version! Thanks ALSchwalm!!!!!!

jact10, 2018-10-10:
I tryed with Windows XP/7/8/10 and works good, this night i will test it out with KALI and ubuntu and i Will let you know

GunnarSpawn, 2018-10-10:
@jact10 I had Parrotos Debian pentesting OS work I suspect the Kali one should work similarly. If you install the OS to the virtual drive you can even run it in live mode versus just use installer.

jact10, 2018-10-11:
Linux Woked perfectly fine.!!! all my problems has been resolved!

GunnarSpawn, 2018-10-11:
same, thanks for all your hard work! @ALSchwalm

lorddaveron, 2018-10-11:
I ended up rebuilding the image on the SD card with the new beta version
and so far it is working better.  I was able to see the image show up as an
option on one of my machines.  Thank you for the fixes.

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

ALSchwalm, 2018-10-16:
It sounds like this has been resolved. If anyone is still having issues, please ensure you are running a version of pISO OS 1.1.0 or newer.

Closed 2018-10-16.

Thread 34 (2018-10-02):

Vendor ID (VID) Product ID (PID) Customization Request

jark22, 2018-10-02:
It would be nice to be able to change VID/PID arbitrarily using a configuration somewhere convenient.  Then you could spoof a Sandisk USB drive for example or something like that or some other specific device that was "supported/allowed"

ALSchwalm, 2018-10-02:
I have considered this, but I hesitate to do it due to the potential legal ramifications. If someone really wants to do this, I think it is simple enough to compile the image from source with that modification.

Closed 2018-10-02.

Thread 35 (2018-10-03):

Trouble with Windows ISOs

ALSchwalm, 2018-10-03:
Some users are reporting issues with windows isos only shows a single text file when mounted with the pISO. I need test this out.

jact10, 2018-10-03:
I have same issue

jact10, 2018-10-03:
UDF file system iso image; thats the problem!  ALSchwalm please check!

jact10, 2018-10-03:
This disc contains a "UDF" file system and requires an operating system that supports the ISO-13346 "UDF" file system specification.

jact10, 2018-10-03:
maybe this work https://ubuntuforums.org/showthread.php?t=1751442

sudo mount -t udf /dev/dvd /mnt

jact10, 2018-10-03:
its going to be a little complicate, because you have to detect or the person manually have to choice what type of ISO is, like does YUMI

robiwisc, 2018-10-04:
I get the same thing on various Windows based ISOs.

> This disc contains a "UDF" file system and requires an operating system
that supports the ISO-13346 "UDF" file system specification.

jact10, 2018-10-04:
And when I try to boot the iso, ask me for drivers

ALSchwalm, 2018-10-04:
@jact10 I have had issues with that when I am not booting EFI (which fails for some reason on certain machines). But if you can boot the virtual cd EFI, that will probably resolve your issue.

ALSchwalm, 2018-10-16:
If anyone is still having trouble with this, please let me know. The issue should be resolved in any release 1.1.0 or newer.

Closed 2018-10-16.

Thread 37 (2018-10-03):

Password protecting volumes

sauerjc65, 2018-10-03:
Is it possible to password protect the volumes on the pSIO? I’m browsing the documents but could not find anything.   Also would it support an external hard drive attached to the piZero?

ALSchwalm, 2018-10-03:
Unfortunately, we don't have plans to support password protecting volumes. This is mainly because there isn't an obvious way to have the user actually enter a password on the pISO (other than over bluetooth for Pi ZeroWs). Of course, normal encryption methods like BitLocker or LUKS will work with pISO virtual drives.

There is also no way to attach an external hard drive to the Pi Zero. This is because the USB controller on the Pi cannot act as both a USB client (for the connection to the PC) and a USB host (for the connection to the hard drive) at the same time.

I'm going to go ahead and close this ticket, but please feel free to open it again if you still have questions.

sauerjc65, 2018-10-04:
I wish I knew all of this prior to purchasing. Basically,  this is just a fancy, large,  usb drive with a lot of unused computing power.

GunnarSpawn, 2018-10-13:
It said in the kickstarter page as well the comments during it's backing period what it could or couldn't do. People asked tons of questions and I asked actually the exact same question haha so I feel you.

 I love it personally  though it's a network capable usb or installer other times for me at least among other things. I've been running live images to test and running them persistent to a virtual drive to keep multiple going.

It's a limitation for the pi acting as a usb host or usb hid device same time so it's not exactly @ALSchwalm's fault he worked with what he had :p.

Closed 2018-10-03.

Thread 38 (2018-10-03):

Can't boot USB bootable enabled Pi3B/3B+ using pISO

ukscone, 2018-10-03:
Only done cursory tests so far but not been able to use a pISO to boot an USB boot enabled Raspberry Pi. Only tried with a drive with IchigoJam BASIC4Rpi so far as it should have been the thing that would cause the least amount of problems as it's just files in a FAT32 partition.

Has anyone had any success booting a pi using pISO?

mikerr, 2018-10-06:
I had the same problem, it seems by default the pi doesn't wait long enough.

I've just successfully booted my pi3 from pISO  though:

The fix is to insert an sd card with only bootcode.bin and an empty file called TIMEOUT on it.
That adds 5 seconds to the wait for USB enumeration, which is enough for pISO to initialize.

I think there may be a config.txt flag to make that permanent in the OTP so you won't need to use an SD card again.

mikerr, 2018-10-06:
Just to add that was actually a Pi3B+
the same doesn't appear to work on my Pi3B despite it being USB-boot enabled ?!

Thread 42 (2018-10-07):

Trouble copying files larger than 200MB over SMB

ALSchwalm, 2018-10-07:
A user has reported difficulty copying larger files (>200MB) via SMB.

joedemo42, 2018-10-10:
Can confirm. SMB advertises around 200MB of free space regardless of free space and SD card size (64 GB in my case, 5 GB used). Also, it would probably be better to serve each drive as an individual share - not all together as folders inside "mount" - as that would allow your SMB daemon to correctly report the free space for each individual drive.

ajanulis, 2018-10-10:
Same there - even 80MB is not possible. Commenting there just to be informed about activities

ALSchwalm, 2018-10-15:
This should be fixed in the latest beta: https://github.com/ALSchwalm/pISO/releases/tag/v1.2.0-beta.1

ajanulis, 2018-10-16:
Unfortunately, on OSx it doesn't work. See attached screenshots - even
Samba rejects to work.

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

ALSchwalm, 2018-10-16:
@ajanulis Your file did not attach correctly. I have tested this on MacOS Sierra and it is working correctly. Are you authenticating as the 'piso' user (or whatever user you have configured in your `piso.config`)?

ajanulis, 2018-10-16:
@adamschwalm@gmail.com <adamschwalm@gmail.com> are you connecting from OSx
via wifi? It works correctly if I just plug it into USB, but over wifi it
rejects on samba, o ftp it mounts as read only. And yes, I am using correct
usearname and password - otherwise I will not be able to connect to if with
ftp. This is why I've attached these screenshots

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

joedemo42, 2018-10-16:
Can confirm it works as expected. ~500MB successfully transferred. Thanks for the quick fix.

ajanulis, 2018-10-16:
@joedemo42 are you using Win or OSx? Wifi of USB?

joedemo42, 2018-10-16:
@ajanulis Wifi/SMB obviously. Also, MacOS X 10.13.6.

ajanulis, 2018-10-16:
@joedemo42 - hmm, same 10.13.6 here. How you power it? Maybe I got all this due to powering it from USB power bank? Have no idea where to start digging

joedemo42, 2018-10-16:
@ajanulis I just plugged it right into my 2012 MacBook Air. No additional power. Let me know if you need me to try something. Maybe I can help you!

ALSchwalm, 2018-10-17:
I just tested the latest beta on my 2017 MacBook Pro (also 10.13.6) and it seems to be working. Just to test, I also tried it while powered from a phone charger and had no issue.

ajanulis, 2018-10-17:
thanks all, tested with another MacBook and everything works as expected!
Sorry for fake warning - looks like my OSx is somehow screwed up :( time
for fresh installation. By the way, @adamschwalm@gmail.com
<adamschwalm@gmail.com> , as you are saving some customers settings in a
file, it might be good to save OLED orientation as well - it's not a big
deal, of course, rotate it each time I power it, but... just a nice feature.

Thank you once again and happy hacking!

p.s. I also had an idea to use it as flash drive for music in a car (with 2
different playlists on different virtual Drives - one for my, one for my
girlfriend), but that BT/USB player/amplifier can't access drives as then I
plug it in, pISO stays in "loading" state all the time.

Aidas

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

Thread 43 (2018-10-07):

Broken PISO

TheRealBastiaan, 2018-10-07:
My piso is delivered. But I have two broken pins on the board (power pins)

ALSchwalm, 2018-10-08:
I'm very sorry your product arrived damaged. Could you please send some pictures of the damage to 'product@piso.support', and we will put in a claim with the distributor. I apologize for the inconvenience.

TheRealBastiaan, 2018-10-08:
No problem can happen.
Thanks for the quick response

Closed 2018-10-08.

Thread 46 (2018-10-09):

pISO not working

hfjensen, 2018-10-09:
I received both the pISO’s I had ordered, but only one is working.
Tha bad one boots up ok, but the ‘down’ button does not work, and then randomly it will flip the screen upside down.
After the flip the new ‘down’ button works, but then of course the ‘up’ button now does not work.
I have tried to swap the pISO to my other Raspberry Pi zero, but the issue moves with the pISO.
Please advise.

hfjensen, 2018-10-19:
I received the replacement and it works great, thanks.

Closed 2018-10-19.

Thread 48 (2018-10-10):

Don't disconnect all drives when enabling additional drives

joedemo42, 2018-10-10:
Let's say I have Drive1 mounted. As soon as I enable Drive2, Drive1 gets disconnected (with all the warnings on OS that do that) and afterwards both Drive1 and Drive2 are remounted. Is that really necessary? Would it be possible to just connect Drive2 additionally?

xela92, 2018-11-28:
That will be an huge improvement, actually if I'm trasferring data to a drive an want to switch on a second one to see a file, I need to wait for the trasfer to complete unless I want it to interrupt itself.

Thread 51 (2018-10-12):

Device Descriptor Request Failed

GiovanniANVitale, 2018-10-12:
on plug in of piso to Windows 10 Device, error in device manager states: A request for the USB device descriptor failed.

ALSchwalm, 2018-10-13:
I'm sorry you're having troubel. Does the pISO appear to be booting up correctly? Can you verify that this problem happens with other machines as well?

GiovanniANVitale, 2018-10-13:
Booting up appears fine, menu structure is intact and  able to create virtual drives etc, but the device doesn't get detected by the local computer as being valid. I've tried two windows 10 devices so far, I'd suspected the usual Pi to Windows 10 connectivity problems with drivers etc, but nothing has worked so far. I'm going to build a Windows 7 machine in the morning to test against to see if the behaviour changes between Operating systems, or if the issue follows the pISO.

GiovanniANVitale, 2018-10-14:
Tried with Windows 7, alternate SD card and PI, but still not recognized by the hardware as a valid USB device.
Could this be a hardware fault?

ALSchwalm, 2018-10-14:
It certainly seems like this could be a hardware issue. In order to confirm that, could connect your pISO to the computer with microUSB cable? This way, the raspberry pi will be handling all of the USB communications, so I would expect the issue to not occur. If the problem only happens with using the usb plug on the pISO, then it is likely a hardware fault.

GiovanniANVitale, 2018-10-17:
Looks like both pi were the problem, ordered another zero w, and it works like a charm. Thanks for the help. Closing.

Closed 2018-10-17.

Thread 54 (2018-10-15):

Couple of feature requests

asmagill, 2018-10-15:
For consideration, I have a couple of feature requests.

Firstly, for my use case, except when I travel, I'm expecting to mostly leave this plugged into one of my machines and then access the shares over the Wifi... it would be nice if a specific wifi definition could be marked for "auto-connection" on boot up so I don't have to select it in the menu each time I have to unplug/replug the device in.

And secondly, while I'm sure you hope it slows down soon, since there *are* updates occurring somewhat regularly, it would be useful if there was a way to apply the updated files without having to pull the device out and remove the SD card each time.

The ideas that came to my mind for how this might be implemented are:

1. Make the /boot partition a mountable virtual drive through the pISO. I'm assuming that internally the partition is mounted for the pISO operating system, so this probably would require unmounting it internally when it is selected and then remounting it afterwards... not sure how often your code access it during normal use so no idea if this is even feasible.
2. Allow the /boot partition to be shared over Wifi but not as an attached virtual drive. Likely easier programmatically than 1, but only useful if you're using a Pi Zero W.
3. Like the ISOS folder, have a special folder which is scanned for each (a specific?) virtual drive for updated files and move/copy them when they change. Could be slow if all virtual drives are to be scanned.

And if this feature is implemented, you'd also need to add a "Reboot" menu item in the Options section.

joedemo42, 2018-10-16:
Maybe make 1) and 2) kind of a debug option in the options menu. 3) seems to me to be impractical since the pISO would have to be able to read every filesystem. Also, does the buildroot kernel have some kind of FAM enabled? dnotify, inotify or what the kids use these days... The move/copy job sounds like a way to specific task for a general feature. Maybe extend buildroot with some script to do that for yourself?

Thread 55 (2018-10-15):

Drives issue

Marnunz, 2018-10-15:
After a connection with usb-c (as shown in the attached picture) the pISO doesn't recognize drives anymore. I can create every drives i want,everythings seems alright, but my iMac and also Win 10 O doesn't load anything.

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

ALSchwalm, 2018-10-15:
The Raspberry Pi Zero has MicroUSB ports not USB-C ports, are you sure you're using a usb-c cable? I wouldn't expect that to even power on.

Marnunz, 2018-10-15:
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

ALSchwalm, 2018-10-17:
So can you confirm that the cable you were initially using (the black one) was USB-C and not micro usb? And you were previously able to view the virtual drives you create?

Thread 56 (2018-10-16):

cdrom emulation not supported by Kali

BigTexun, 2018-10-16:
In doing some testing with the ISOS folder support, I attempted to boot Kali.

The bios portion of the boot saw the selected ISO as a CD drive,  The boot kernel loaded, but was then unable to see the CD drive to complete the boot.

I've seen this before, when the correct CD driver is not present in the boot kernel.  So this seems to be Kali's problem, not PISO.  However there could be other systems with similar problems.   I used to see this problem a lot when working with a Dell that had one of the first SATA CD drives, before the SATA CD drives were commonly supported in the Linux default kernel.  Sometimes the problem is only with the boot kernel on the ISO, and if you are running the installer, a more complete kernel is installed.  The fix back then was always to go get a parallel IDE drive, and install from that.  I'm sure this isn't the exact same issue, but it is very similar.  I can't tell if the driver is missing, or if the PISO virtual CD is supported but unrecognized.  Where this is the largest issue is going to be for live ISO's, where the boot kernel is the kernel you need to run always.

I tested wit Kali  2017.2 (an admittedly old version of Kali, but not THAT old).  I will cast a wider net and see how common this is across various ISOs I frequently use, and I will test with a more current Kali.  Unless this turns out to be a common problem, I'm inclined to blame this on Kali, but I wanted to put this here in case other people are seeing a wider problem with other distributions

Kali boots to the grub menu, and depending on what you select you may or may not see the error displayed, which indicates the kernel can't find the CD.  In some modes I get to watch the kernel try multiple drive types as it looks for the boot device.

BigTexun, 2018-10-21:
I will retest with 1.1.0 as it looks like you fixed a related issue affecting windows images (which is on my list to test with).  I suspect the issues are related or the same.

Thread 59 (2018-10-16):

Request: Sorting menu items according to updated name set in config

yllwfsh, 2018-10-16:
This is not really an issue, just a feature request:

Would it be possible to sort the menu items according to the new name that's set in the config? That way people with a lot of drives and iso's (me included) can create some order to their list :)

ALSchwalm, 2018-10-17:
I think this is a good idea. I will probably add it as an option in the config, just to avoid changing anyone's current layout. This will probably make it in to 1.3.0

yllwfsh, 2018-11-04:
This works amazing in version 1.3.0b2 !!! Thanks!

Thread 63 (2018-10-18):

Screen Flip

Tokn59, 2018-10-18:
Hello, not really an issue but it would be really useful if we had an option to flip the screen so that when inserting it left or right of the Pc the text can be flipped so it's not upside down. Would that be possible ?

Thanks and kind regards,

Tony

ALSchwalm, 2018-10-18:
Hi Tony, this feature is actually already available. You can flip the screen by long pressing the 'down' button. Thanks for the feedback though!

Closed 2018-10-18.

Thread 66 (2018-10-19):

Locking up upon creating or deleting a drive

tinjaw, 2018-10-19:
I just flashed my sd and put it in and it booted up just fine. I can create a drive, but the onscreen menu locks up. I can pull the pISO out and reinsert and it boots up fine. The drive is there and usable. But if I delete it, the same thing happens. It freezes up.

ALSchwalm, 2018-10-22:
Hi tinjaw, thanks for the report. Can you please create a file called 'piso_debug_log' on your SD card. Then insert it in to the pISO and plug the pISO in to a computer. When you create a drive (and it locks up), unplug the pISO and the SD card. There should be a file called 'piso.log' on the SD card. Upload that here and we should be able to help debug things.

tinjaw, 2018-10-30:
[piso.log](https://github.com/ALSchwalm/pISO/files/2527588/piso.log)
 I finally found some time to try it. Here is the log file.

For this test, I downloaded a fresh img from the releases. I flashed a brand new image to a 64 GB SD. I did not plug it into a USB port. To make sure it had nothing to do with my computer, I plugged power into the pISO directly. Created a disk and it froze.

Thread 71 (2018-10-23):

Drive Corruption

Tokn59, 2018-10-23:
Sometimes it seems drives get corrupted. Repro steps ;
- Create - Windows NTFS
- Activate drive
- Copy files to drive
- Safely eject Drive
- Insert stick in other Pc
- Drives is shown in Explorer
- Click on drive
- Results in error : Location is not available. E:\is not accessible. The file or directory is corrupted and unreadable.

C:\Users\tonyk>chkdsk E:
The type of the file system is NTFS.
Volume label is Drive2.

WARNING!  /F parameter not specified.
Running CHKDSK in read-only mode.

Stage 1: Examining basic file system structure ...
  512 file records processed.
File verification completed.
  0 large file records processed.
  0 bad file records processed.

Stage 2: Examining file name linkage ...
Error detected in index $I30 for file 5.
Error detected in index $I30 for file 5.
Index entry DS09DF~1.JPG in index $I30 of file 5 is incorrect.
Index entry DS21BD~1.JPG in index $I30 of file 5 is incorrect.
Index entry DS4DD3~1.JPG in index $I30 of file 5 is incorrect.
Index entry DS6CA1~1.JPG in index $I30 of file 5 is incorrect.
Index entry DSAB42~1.JPG in index $I30 of file 5 is incorrect.
Index entry DSB2C0~1.JPG in index $I30 of file 5 is incorrect.
  534 index entries processed.
Index verification completed.

Errors found.  CHKDSK cannot continue in read-only mode.

Already had this issue a few times.

Tony

Thread 74 (2018-10-24):

Overflow when choosing volume size

TheOneValen, 2018-10-24:
System:
* pISO version 1.1
* 200GB microSD
* Configuration:
- Step size 2%
- Initial size 10%

Description:
- Make new Drive
- Press the lower button until reached 0 (which would make no sense, too ;))
- Press lower button again: Impossible large percentage and size is displayed.

Have not tried to make the drive (scared) but when pressing up again it looks normal again.

Greetings!
Valen

ALSchwalm, 2018-10-24:
Thanks for the report! This will be fixed in 1.3

Thread 76 (2018-10-26):

Add download system to get ISOs directly on drive(s)

lgnap, 2018-10-26:
Maybe a direct downloader (like a web wget) and/or a torrent client.

Often Linux ISOs come with a direct download or torrent/magnet link, it's interesting to give it directly to pISO.

Thanks

ALSchwalm, 2018-10-31:
I think this is a bit beyond the scope of this project, so I'm going to close this issue. But thank you for the feedback!

Closed 2018-10-31.

Thread 78 (2018-10-29):

Feature request for the distant future - Encryption

simontravaglia, 2018-10-29:
Just thinking about it, it would be nice to have the ability to have an encrypted drive.
Maybe when you mount the drive you're prompted for a password:
 Up/Down    cycles through the alphabet for each character
 Select          Selects the letter and advances one character (which scrolls round on itself)
 At the end/beginning of the password there's a <BACK> so you can abort the mount.

jgoergen, 2019-07-11:
I formatted a drive on it as a bitlocker encrypted volume on windows 10 and it's been working great that way as well.

simontravaglia, 2019-07-11:
Yes, I think I'll end up splitting the device into encrypted and unencrypted  volumes as there's some stuff I want available to all platforms (i.e. media) and personal stuff I want protected.   Ta

Thread 81 (2018-10-30):

Card speed issues

sunbit, 2018-10-30:
I have speed issues copying to/from a pISO drive:

- SD card is a Samsung EVO Plus 128 Gb, class 10.
- Copy tests done with a single 4.57 Gb file.
- v1.2 firmware

Testing with the raw sdcard, 1 partition of 128GB ExFat:
- Write speed: 77 Mb/s
- Read speed: 97 Mb/s

Testing with a single drive created in pISO, 100% of capacity
- Write speed: 5.5 Mb/s
- Read speed: 14 Mb/s

I don't now if this can be caused by the raspberry pi or the pISO, but as you can see I have a 15x difference between copying files to/from the raw sdcard, vs copying files from a drive defined using pISO with the same card.

Any idea?

Thank you

appcoders, 2018-11-17:
Yes would be interesting if its a Raspi hardware issue...

xela92, 2018-11-27:
I'm facing this issue too, I have Samsung EVO Plus 128GB too, and I'm doing less then 5 MB/s writing.

Willena, 2018-12-23:
I've also face this issue. I looked through the internet and here is what I found

http://www.pidramble.com/wiki/benchmarks/microsd-cards

There is nothing about the Pi Zero itself but I think it's similar to other Pis.
Most interestingly this is the of the last sentence of the author : " (Note that most of the above benchmarks, when run on a USB 3.0 card reader on my MacBook Air, show 5, 10, or 15 times greater performance in that environment)"

extremeshok, 2019-04-02:
Create the volume as ext3 and test, the nfs/fat32 is extremely slow.

im getting a 3x boost with ext3

Willena, 2020-02-16:
I've been trying things today and found out that things can somehow probably be improved.

Before anything, here are the measurements made using the pISO:
* Read : ~17MB/s
* Write: ~5MB/s

I tested the read and write speed of my micro sdcard from a fresh install of raspbian, using the script in [this ](https://www.raspberrypi.org/forums/viewtopic.php?t=144493) thread.  The result I got were encouraging !
* Read : ~18MB/s
* Write: ~17MB/s

As suggested by the thread, I added the `dtparam=sd_overclock=100` in my `/boot/config.txt`. The previous results has almost doubled:
* Read: ~38MB/s
* Write: ~32MB/s

This shows us that USB read write are being slowed by either LVM or the usb_gadget module (g_mass_storage). pISO is runnning on usb_gadget module of the kernel. pISO seams to be also using LVM for the drive management (please correct me if i'm wrong).

Using only a bin file NTFS formated and usb mounted (`modprobe g_mass_storage file=/data/file.bin ro=0 stall=0`) I got:
* Read: 31Mb/s
* Write: 10-17Mb/s
These read write speed even if they are slower than what the raspberry pi can handle (see second sdcard test, with `dtparam=sd_overclock=100`) are more acceptable.  For the moment theses are just measurement and tests. It seams that the only thing left to test is LVM...

To be continued 😄

Thread 83 (2018-11-01):

Drives not recognized by Windows 10 Pro

pmeyerdk, 2018-11-01:
Hi,

I have the following issues, when trying to connect pISO to my Windows 10 Pro PCs USB port.

1) When inserting pISO into my USB port, it seems to boot succesfully and show the menu.
But my Windows displays the following error message: "USB device not recognized".
2) When then trying to created drives on pISO, it seems to create and format succesfully.
But my Windows displays the following error message, when activating a drive in the pISO menu: "USB device not recognized".

As mentioned, I am running Windows 1 Pro.
My PC is a Dell XPS 15 9570, with and i7-8750H processor, 16 GB RAM and 512 GB.

I haven't had the chance to try pISO in another PC yet.
But wanted to report this, since I usually don't have issues connecting USB key to this laptop.

Regards,
Peter Meyer

ALSchwalm, 2018-11-02:
Hi @pmeyerdk what version of the pISO OS are you using?

pmeyerdk, 2018-11-02:
Hi Adam,

I am using version 1.3.0, more precisely the newest version I could find,
being version 1.3.0-beta.2.

/Peter

On Fri, Nov 2, 2018 at 1:30 AM Adam Schwalm <notifications@github.com>
wrote:

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

pmeyerdk, 2018-11-02:
I just tried to install v.1.2.0 instead of the newest one.
Though, this didn't make it work better, since I still get the same error message.

My SD card is a SanDisk Ultra 32GB HC I.
And I'm using Etcher to put the system on the SD card.

/Peter

ALSchwalm, 2018-11-03:
Thanks for helping debug this. Can you try connecting the raspberry Pi to you machine via a micro USB cable directly to the raspberry Pi? This will eliminate any potential hardware issue with the pISO USB header.

pmeyerdk, 2018-11-04:
No problem!

Connecting to my PC using a cable in one, actually both, USB ports of the
Pi, did not work any better.
One port had the same errors, and the other seemed to not have any
reactions on the PC at all.

Can it be pin connections not aligned completely?

It seems a little puzzling, since pISO seems to work while being used.
So it must be able to read the SD card, and get some power as well.

/Peter

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

ALSchwalm, 2018-11-07:
If the issue is still occurring when the USB connection is being made directly with the Raspberry Pi, it is probably not a problem with the pins. I suspect the issue is with the USB controller on the Pi (I have seen a couple of cases of this). Do you have another Raspberry Pi you could test with? If not, we can test the Pi if you have experience using a serial cable to connect to your Pi.

pmeyerdk, 2018-11-21:
Hi again,

Do you have any pointers, as to how I could continue testing this issue, to hopefully get it solved?

Thanks :-)

ALSchwalm, 2018-11-21:
Sorry for the slow reply on this. For your other Pi's, are any of them configured to use wifi and give you ssh access? If so, you may be able to just transfer the SD card to the Pi Zero you're using and get in to it that way (if it is a Pi Zero W).

pmeyerdk, 2018-12-30:
Hi again,

I got a friend, who's working with electronics and embedded software, to take a look at my pISO.
He took it to work, to check it with proper equipment and found the cause of my issue.

Pogo pin USB D+ and D- is shortwired.
So, apparently my issue is caused by an error in production.

My friend fixed my pISO for me.
But I haven't had a chance to check it myself yet though.
I wouldn't have had a change to find this our myself.

Best regards,
Peter Meyer

Thread 84 (2018-11-08):

pISO Doesn't seem to boot

TheEagle13, 2018-11-08:
I installed my pISO, and flashed the SD card according to the instructions. I get the pISO loading screen, then it disappears and nothing comes up. If I hook up the Pi to HDMI, I just get a rainbow square on the TV. Any suggestions?

Loading...
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

After Loading...
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

HDMI Output...
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

TheEagle13, 2018-11-10:
@ALSchwalm I am waiting patiently for a response for suggestions.

@Thomas-Bastiaens
This is not related, please don't hijack other's threads with irrelevant info. If you cannot find a relevant thread, make your own.
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

ALSchwalm, 2018-11-12:
@TheEagle13 Sorry for the delayed response to this. Can you please a filed called 'piso_debug_log' on the root of your sd card. This should cause the pISO to create a file called 'piso.log' which may contain info helpful in diagnosing this.

khuzthul, 2018-11-12:
same issue here, I´ve tried with various sdcards and is always the same.
I have managed to launch piso two times, but it gets stuck when formatting the drives.
I attatch the debug logs i have, please let e know if there is something to do.
[piso_error.log](https://github.com/ALSchwalm/pISO/files/2571603/piso_error.log)
[piso_format_drive.log](https://github.com/ALSchwalm/pISO/files/2571604/piso_format_drive.log)
[piso_error_creating drives.log](https://github.com/ALSchwalm/pISO/files/2571605/piso_error_creating.drives.log)

[piso_format_drive.log](https://github.com/ALSchwalm/pISO/files/2571596/piso_format_drive.log)
[piso_error.log](https://github.com/ALSchwalm/pISO/files/2571598/piso_error.log)
[piso_error_creating drives.log](https://github.com/ALSchwalm/pISO/files/2571599/piso_error_creating.drives.log)

TheEagle13, 2018-11-12:
@ALSchwalm I don't have one. It never produces one. I should have thought to mention that in the initial post.
I'm not sure why people (like @khuzthul) keep hijacking threads with unrelated issues (probably because they don't know how github works ) but none of these other posters seem to have issues related to mine. I cannot get pISO to launch ever, no error logs ever produce.

khuzthul, 2018-11-12:
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

@TheEagle13 sorry to bother you, i have replied only because i have the same issue. the only difference is that i have the error logs to show.

@ALSchwalm please let me know if i have to open another issue, or if you need more data.

TheEagle13, 2018-11-12:
@khuzthul Not to start an argument, but if you read, my issue is that I cannot get pISO to load at all, yours is that you have issues with formatting.

rlights, 2018-11-12:
Just got my pISOs and have the same issue. Loading and then nothing, Unfortunately I don't have a HDMI adaptor handy, but I am also not seeing any logs produced after inserting the trigger file.

@ALSchwalm I did notice [some pogo pins aren't seating properly](https://photos.app.goo.gl/zsmpyoUYcZwAoGg16); I doubt this would prevent the Pi booting by itself, but maybe?

ALSchwalm, 2018-11-12:
@TheEagle13 To be clear, you have created the 'piso_debug_log' file on your SD card and it still does not product a debug 'piso.log' log file?

TheEagle13, 2018-11-12:
My apologies, I misunderstood that as a statement as opposed to a request. I created the file, and the only thing created in the piso.log is as follows:

`Building display manager
Building USB gadget
Building pISO`

ALSchwalm, 2018-11-13:
@TheEagle13 That's very strange. I've gone ahead and made a build with some more logging that will hopefully give some idea of at least what's happening there. I'm assuming that some operation is hanging during that setup phase, but I'm not sure what it could be. When you get a change, please update to this and get the log.
[update-more-logging.zip](https://github.com/ALSchwalm/pISO/files/2578571/update-more-logging.zip)

ALSchwalm, 2018-11-13:
@rlights How are you connecting the pISO? Could you try using a micro usb cable to the PI instead of the USB header on the pISO?

steve500, 2018-11-14:
Same exact issue with mine that I had received today. :( Tried all the same suggestions, mine will not spit out a log. With the same SD cards, I can run other Pi software releases without issues. I am using 64gb sandisk sdxc cards. This Pi Zero is brand new, clean contacts. The pISO just splashes the boot logo for a couple seconds and then nothing.

ArdjanB, 2018-11-14:
I had the same issue. Under 1.2.0 everything worked fine, but when I updated to 1.3.0 it seemed to be broken..
* When booting in 1.3.0, the first logo appeared, and it got black again. Normally the logo appears a second time, but now it stayed black.
* Downgraded to 1.2.0 again, but the same issue: 1 logo, then black.
* Tried to get a log file: under 1.2.0 and 1.3.0 that didn't work
* Tried the update-more-logging.zip, and that worked: the pIso booted (1.3.0), I could mount disks, etc. This time I got a log file:
[piso.log](https://github.com/ALSchwalm/pISO/files/2583035/piso.log)

steve500, 2018-11-15:
ArdjanB, I tried the update-more-logging.zip update files and still cannot get my piso board to boot. Did we get duds?

ArdjanB, 2018-11-15:
It seems to be solved. I can now boot normally in 1.3.0.

I can't exactly pinprick the reason, but I had some problems with copying the 3 update file to the MicroSD card. Sometimes the copying would not start at all, etc. But I just now tried to delete the three files first, before I copy the new files, and that worked every time, with both 1.3.0 and these update-more-logging files.
I would currently say it was an incorrect overwriting of (one of) the three update files. I just dragged and dropped the files under Windows 8.1 and Windows 10.

TheEagle13, 2018-12-05:
@ALSchwalm
Sorry about the delay in getting back to you and testing, I was on vacation. Anyway, using the Update more logging that you sent, I was able to boot once, and (i think) create a drive of 95%, but it no longer boots after the drive was created. Here are the logs. Also as a side note when it was booted, every time I would press a button it would shift the screen to the left by about 10%.

```Building display manager
Building USB gadget
Building pISO
Constructing VolumeGroup
Building drives from VolumeGroup
Building NewDrive menu item
Building Stats menu item
Building WiFi menu item
Building Options menu item
Focusing
Shifting focus to window id=2
Configuring user
  Adding user
  Doing bindfs
Finishing pISO construction
Restoring State
Rendering pISO
Positioning windowid=1
Blitting to (0, 0, size=(0, 0) scroll_shift=0)
Positioning windowid=2
Blitting to (0, 0, size=(82, 9) scroll_shift=0)
Positioning windowid=3
Blitting to (0, 9, size=(55, 12) scroll_shift=0)
Positioning windowid=5
Blitting to (0, 21, size=(31, 9) scroll_shift=0)
Positioning windowid=6
Blitting to (0, 30, size=(47, 9) scroll_shift=0)
Positioning windowid=4
Blitting to (119, 0, size=(9, 40) scroll_shift=0)
Update display with bitmap: 128 by 64
Building controller
controller: UP released without press
controller: DOWN released without press
controller: SELECT released without press
```

TheEagle13, 2018-12-15:
@ALSchwalm Any update? Did I get a dud?

TheEagle13, 2019-02-26:
To add some info to those who may find their troubleshooting steps similar to mine....
The issues appear to be the cheap pogo pins not pushing all the way through. After much troubleshooting and lots of testing of the pins, I would always find 1 or 2 that didn't push all the way through the holes.

I went ahead and just soldered the darn things together, and I have no issues anymore.

Closed 2018-12-31.

Thread 85 (2018-11-09):

Don't power up. First Error.

Thomas-Bastiaens, 2018-11-09:
Hi,
I had first an error, but I didn't got an error file (piso_debug.tar), and now created a piso_debug_log that didn't work.
So I reinstall the system and I had to boot it up for 3 times for it worked.
And after a 10 days it stopped working. And I waited 5 min and it was still booting.
And I reinstall, now it work, but I want it to let you know. That its not smart if I save files on it.

Thanks! Thomas

Sorry for my bad English!

Thomas-Bastiaens, 2018-11-09:
See: [https://github.com/ALSchwalm/pISO/issues/84](url)

Closed 2018-11-09.

Thread 88 (2018-11-16):

error after deleting

khuzthul, 2018-11-16:
I have managed to create 3 partition on the sdcard with pISO but trying to delete one of them ends in an error and the pISO wont boot again.

this is the error i get
_

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

_and this is the complete log.
[piso.log](https://github.com/ALSchwalm/pISO/files/2590058/piso.log)

please help me. its been a nigthmare to work with this.

ALSchwalm, 2018-11-18:
Hi, I'm sorry to hear your having trouble. I've not seen something like this before, what kind of SD card are you using?

khuzthul, 2018-11-19:
hi again

i have tried with two different sdcards, and its always the same. first of all, when it works, it let me create some partitions, but when i try to reconnect it it allways collapse. in some cases, it doesnt boot, and in other cases, it wont format any other partitions, and then nothing happens again.

this is the last error i have.

_

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

_

ALSchwalm, 2018-11-21:
Do you have access to a linux or Mac machine? I would like to completely erase the contents of the SD card by writing all 0's to it (and I can provide the commands to run if you have access to one of those). That said, I don't know how this kind of issue could be affecting two different cards unless there is a problem with the Pi. Have you booted different Raspberry Pi operating systems on that Pi with those SD cards?

khuzthul, 2018-11-21:
hi again, i have access to linux and mac, but i have to say that i have tried this a couple of times and it always ends in error.
last time i managed to boot pISO and create 2 partitions, even i managed to copy isos to one of them, but only the first time, when i disconnect from the pc it doesnt work again.
after that i only get this error _Error: No such file or directory (os error 2)_ and pISO doesnt boot at all.
please send me your commands and i will try.

khuzthul, 2018-11-22:
hi again, i have been doing more test to my pISO.
i have tried this for three times and always is the same results.
1º managed to format in low level the sdcard and format it in FAT32
2º install the OS with ETCHER two times, because the first always fails
3º after install plug pISO in my laptop and wait to boot
4º create the first partition and wait for 10 minutes, nothing happens
5º unplug pISO and check log:
_> Doing actions: [FormatDrive]
> Error while processing 'FormatDrive': Error: Command "lvcreate" (["-V", "53672833024B", "-T", "VolGroup00/thinpool", "-n", "Drive1"]) failed:   device-mapper: reload ioctl on  (254:2) failed: Block device required
>   Failed to activate thin pool VolGroup00/thinpool._
6º plug in again and create again the same partition, this time goes well
7º unplug pISO again to see the log
_> Doing actions: [CloseFormatMenu, CreateDrive(LogicalVolume { name: "Drive1", path: "/dev/VolGroup00/Drive1", size: 53674508288 })]
> Shifting focus to window id=2_
8º plug in again and then nothing more pISO dont work again.

please help me, i think my pISO is not working well. I have tried the Raspberry with raspbian and it works well with this sdcard.
is there any way to unplug pISO securely or something like that?
how can i create my partitions and have it work without losing it when i disconnect?

thank you.

Thread 89 (2018-11-20):

pISO UI glitches around.

MithicalM, 2018-11-20:
What the title says.
Video: https://youtu.be/2XgyFz_1lqA

ALSchwalm, 2018-11-21:
Hi @MithicalM, I'm sorry your having issues with your pISO. Issues like this are typically caused by a poor connection between the pISO and the Raspberry Pi. Could you ensure all of the screws are tightly screwed on?

ArdjanB, 2018-11-26:
I am seeing the same things. I'm on 1.3.0

TheEagle13, 2019-01-01:
@MithicalM @ArdjanB @Thetmar
I had the same issues, and it actually was a poor connection between the pins. I found that the included spacers were actually a hair too tall. after removing them and reinstalling (tighten so it's tight but not warped) and you should be good to go.

TheEagle13, 2019-02-26:
To add some info to those who may find their symptoms similar....
The issues appear to be the cheap pogo pins not pushing all the way through. After much troubleshooting and lots of testing of the pins, I would always find 1 or 2 that didn't push all the way through the holes.

I went ahead and just soldered the darn things together, and I have no issues anymore.

MithicalM, 2019-02-26:
Honestly. I have given up at this point. This thing is really badly made
and I've just had constant issues and no real help or feedback from the
devs on how to get it sorted. Just unacceptable really.

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

TheEagle13, 2019-02-26:
I agree, they farmed out production to the lowest bidder, and it shows (But it was a kickstarter, not a retail product). I'm not too sure what happened to the Dev team, they probably got tired of the complaints. But the concept, and at least for me the use cases, are really practical and useful. Much better than the Big Zalam Virtual CD Drive thing I've been carrying around for years. Once I did the in depth troubleshooting and discovered that soldering the pins was the fix, I haven't had an issue since. (And I had issues just as much as you did)

Thread 90 (2018-11-25):

Nothing happens when mounting drive

jimmirehman, 2018-11-25:
pISO boots up fine and the UI operates as it should but when creating a drive, and mounting it, the pISO shows the little square next to the drive but nothing happens on the computer/ Ive tried 2 macs and 1 PC, none of the machines recognize the drive.

jimmirehman, 2018-11-25:
I tried on 3 different pi Zero W units, all work perfectly fine for every other project.

jimmirehman, 2018-11-25:
ok i compared my unit to the pics on the website, Mine is missing 2 GPIO pins.

Thread 91 (2018-11-27):

[BUG] crash creating ISOs folder on NTFS drive

xela92, 2018-11-27:
Hi there,

I found out a bug. If I create an NTFS drive, create an ISOs folder on it, put some ISO file inside, mount it and try to umount it, the interface crashes and I need to unplug and replug pISO to make it work again.

Tried to rename the ISOs folder, and the issue is gone. Renaming it again in "ISOs" (or if the directory name just starts with "ISOs"!!), the issue appears again. I'm attaching [piso.log](https://github.com/ALSchwalm/pISO/files/2621728/piso.log) captured while crashing.

ALSchwalm, 2018-11-28:
Hi, @xela92, I'm sorry to hear you're having trouble.

Can you confirm what version of the pISO OS you're running? I haven't been able to reproduce this problem. The log file doesn't indicate any issues, which is a bit odd. When you say the interface crashes, do you see the "An error occured" screen? If so, you should have gotten a 'piso_debug.tar' file that would contain more info.

I suspect the issue is somehow related to case (in)sensitivity on NTFS. The folder should be called 'ISOS' (all caps). Can you try that and see if it resolves the problem?

xela92, 2018-11-28:
Hi, I'm using latest OS version, 1.3.0. no errors showing up, the interface just freezes. I will try your tip and tell you if it works!

xela92, 2018-11-28:
@ALSchwalm renaming ISOs to ISOS as of your suggestion, I could see ISO files with NTFS, and that's great (naming the folder 'ISOs', the ISO files wouldn't show).

I did some other tests and got to a conclusion. It's not related to the ISOs folder, it's related to Windows.

at first, I noticed that when it freezed, after a while (a minute more or less), pISO started working again (and the umount was done), and the issue happened only when I forgot to do unmount in Windows before doing it on pISO (I had issues with unmount process in Windows that took ages, so I started doing umount only on pISO, so I was able to notice this issue). It's related only to NTFS, with vFat for instance if I don't unmount from Windows, the unmount process is done from pISO correctly with no slow downs.

Also, no issues at all with Linux or MacOS, even with NTFS.

I don't know if there's something to do on pISO side to make it faster, but always doing unmount from Windows is a good workaround to this issue (and, of course, a good habit!)

Thanks for the help!

Thread 94 (2018-12-19):

pISO DOA

steve500, 2018-12-19:
I have a brand new Pi Zero W I am using with a pISO I received from Adam a while back, screws and hardware never arrived. I used my own rounded up screws, nuts, and plastic washers to put it together. I flashed the latest release to an SD card and powered it up. I receive the boot splash logo and that is all.

I then tested other SD cards that are known working good but they also do not boot up. I tested HDMI signal and I do get the colored bars. I instead tried flashing my SD cards with other Pi distros and they all boot up and work perfectly via the USB and HDMI port without any issues. The pISO does not work. I have tried getting logs using the log file tricks, tried older releases.

I then updated Adam with a photo of my pISO board, I believe there are two missing pogo pins in blank round trace spots. I have been very delicate with the pISO, I checked the packaging to see if they'd come off in shipping but I did not find anything, since my last email with photos of the board to Adam, I have gotten no response in 8 days now.

I'm going to be patient and figure that life happens, I am optimistic that this can be fixed. Would love to utilize the advantages of the pISO project.

-Steve

TheEagle13, 2019-02-26:
The issues appear to be the cheap pogo pins not pushing all the way through. I had the same issue if you look at issue #84 . After much troubleshooting and lots of testing of the pins, I would always find 1 or 2 that didn't push all the way through the holes.

I went ahead and just soldered the darn things together, and I have no issues anymore.

Thread 96 (2019-02-11):

RFI: Is "Dual" Power harmful?

tinjaw, 2019-02-11:
I hookup my pISO to a cellphone charger to select the drives I want available and the drive I don't I turn off. Then I unplug the phone charger and plug the pISO into my PC. All is then glorious. All Hail pISO !!

Since I do it often, to reduce wear and tear on the hardware, I would like to leave it plugged into the cellphone charger when I plug it into the USB port of my PC. I would then like to be able to remove the pSIO from the PC and have it continued to be powered by the cellphone charger.

Can I do that? Should I NOT do that? What is the airspeed velocity of a Raspberry Pi laden swallow?

james-tate, 2019-02-11:
I would advise against this setup. While the setup should not be harmful, you are relying on the protection circuitry on the charger, and on your computer's USB port. The pi zero, or piso does not contain the necessary circuity. I don't think anything would happen to the pi or piso itself, but you are essentially plugging in your cell phone charger into your USB port on your computer.

tinjaw, 2019-02-11:
That's kinda what I suspected, but I've learned not to trust myself when money is involved. ;-) Thank you.

Closed 2019-02-11.

Thread 97 (2019-03-27):

Should it work via microusb?

Ameb, 2019-03-27:
I had multiple problems with the pogo pins and now i cant remember if the computer should recognize drives when the piso is connected via pi zero microusb ports.

Thank you.

ArdjanB, 2019-07-04:
Yes, it connects to the PC the same, whether you use the ‚main‘ USB port or the one of the two micro USB ports.

Thread 100 (2021-03-06):

seeking for your help about your fork

lionB777, 2021-03-06:
#Hi @No0ne,
I made one piso from your fork, but I don't have the key 2 working, just joystick up and down as expected, what check should I do to get it working ? thanks

No0ne, 2021-03-08:
https://github.com/No0ne/pISO/commit/dbb8a5f0d61b25107724497f50a708638e193ce2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

As you can see here, there are three buttons defined. The select key should be mapped to the button when you press the joystick in. Like on a Playstation controller the joystick is also a button.

lionB777, 2021-03-08:
ok, I missed that, because I made a custom case for it and the way it's made I have missed that. thanks for your help. I'm just a beginner swift coder so I can barely understand your code. Is there a chance that this push button and button 2 or other will work together? because definitely I'll not be able to code it myself. thanks

No0ne, 2021-03-08:
Do you use the Waveshare 1.3inch OLED HAT or something else?

lionB777, 2021-03-08:
I use the same as yours in the project.

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

lionB777, 2021-03-08:
[https://www.icloud.com/iclouddrive/0UXueoED_qb3Pm7_GWPdTgMPQ#image0](url)

No0ne, 2021-03-08:
Hardware approach: solder a wire from pin 33 to pin 38.
https://www.waveshare.com/w/upload/c/c8/1.3inch-OLED-HAL-Schematic.pdf

Software approach one button: change the line
`let select_input = Pin::new(13);`
to
`let select_input = Pin::new(20);`

Software approach both buttons: this would require more code changes!

lionB777, 2021-03-08:
is it possible to do something with a "or" condition ?

No0ne, 2021-03-08:
You need to do the initialization and listen for button presses separately for each pin.
If you don't want to code or compile the hardware approach with a wire between pin 33 and pin 38 on the gpio header or waveshare board should be the easiest.

lionB777, 2021-03-08:
the matter is not that I don't want to compile, it's more that I don't know how, even if if change the pin to 20 like you suggested in the source file

lionB777, 2021-03-08:
but willing to learn how if you don't mind to suggest a how to, please

No0ne, 2021-03-08:
Its documented here: https://github.com/ALSchwalm/pISO/blob/master/README.md

No0ne, 2021-03-08:
If you don't want to code or compile, the hardware approach with a wire between pin 33 and pin 38 on the gpio header or waveshare board should be the easiest solution.

lionB777, 2021-03-08:
ok I'll try, and I keep the hardware approach in mind, thank you.

lionB777, 2021-03-08:
last question, can the raspberry pi listen two buttons for the same action.
so the code would be:

       let select_input = Pin::new(13);
         select_input.export()?;
         select_input.set_direction(Direction::In)?;
         select_input.set_edge(Edge::FallingEdge)?;

        let select_input = Pin::new(20);
         select_input.export()?;
         select_input.set_direction(Direction::In)?;
         select_input.set_edge(Edge::FallingEdge)?;

lionB777, 2021-03-08:
coud it be something like this ?

 let select_input = Pin::new(13);
         select_input.export()?;
         select_input.set_direction(Direction::In)?;
         select_input.set_edge(Edge::FallingEdge)?;

let select_input2 = Pin::new(20);
         select_input.export()?;
         select_input.set_direction(Direction::In)?;
         select_input.set_edge(Edge::FallingEdge)?;

     ......
            down_input: down_input,
            select_input: select_input **(or, don't know the correct syntax)** select_input2,
            up_poller: up_poller,
            down_poller: down_poller,
            select_poller: select_poller,
            last_event: time::SystemTime::now(),

Thread 98 (2021-03-06):

Green LED flashing 2 times after power on

Atheris142, 2021-03-06:
Hi, I was trying to make my own pISO with the github material. I ordered a custom pcb, solder the components and check it was right made.

After following the steps of the wiki for flashing the image into the SD card the pISO does nothing, only the green LED flashes 2 times. I saw that LED code is when the pi can't read the SD card.

I have tried in another raspberry, and multiple SD cards and nothing changes.

If someone can give me a hand i will appreciate a lot.

Thanks in advance.

bofhvp, 2021-11-21:
Hi
I've got the same problem too. Have you managed to resolve the problem, if so how did you go about it ?

Thanks

Atheris142, 2021-11-21:
Hi,
Unfortunately no. I was trying to flash the image a couple of times, watching the block size at formating the SD, trying multiple SD cards and nothing worked.
I finally gave up and haven't tried anything else since.
I wish I could solve it, but I am not that experienced with these issues and the error seems quite vague.

bofhvp, 2021-11-22:
Hi

Which versions have you tried ? I've downloaded version both 1.2 and 1.3, but currently using 1.3 as its the "latest"

Atheris142, 2021-11-24:
I think I used the version 1.3 in all my attempts. I don't remember if I tried the 1.2 version.

Maybe one of these days I will try it again, but I doubt I cuold make it work. Last time I followed step by step the process and didn't work. So I'm pretty lost.

Thread 101 (2022-02-07):

Don't boot via legacy bios i686

expprobationer, 2022-02-07:
I' ve a problemit device see by legacy 32bit biso (i686) As Linux Gadget Device but it don't boot via usb ( there is usb device on my bios work properly with flsh drives only not workimg boot with usb cd/dvdrom), how to fix it?
