ALSchwalm/pISO/pcb/pHAT/pHAT.kicad_pcb

## KiCad design pcb/pHAT/pHAT.kicad_pcb (2018-05-11)

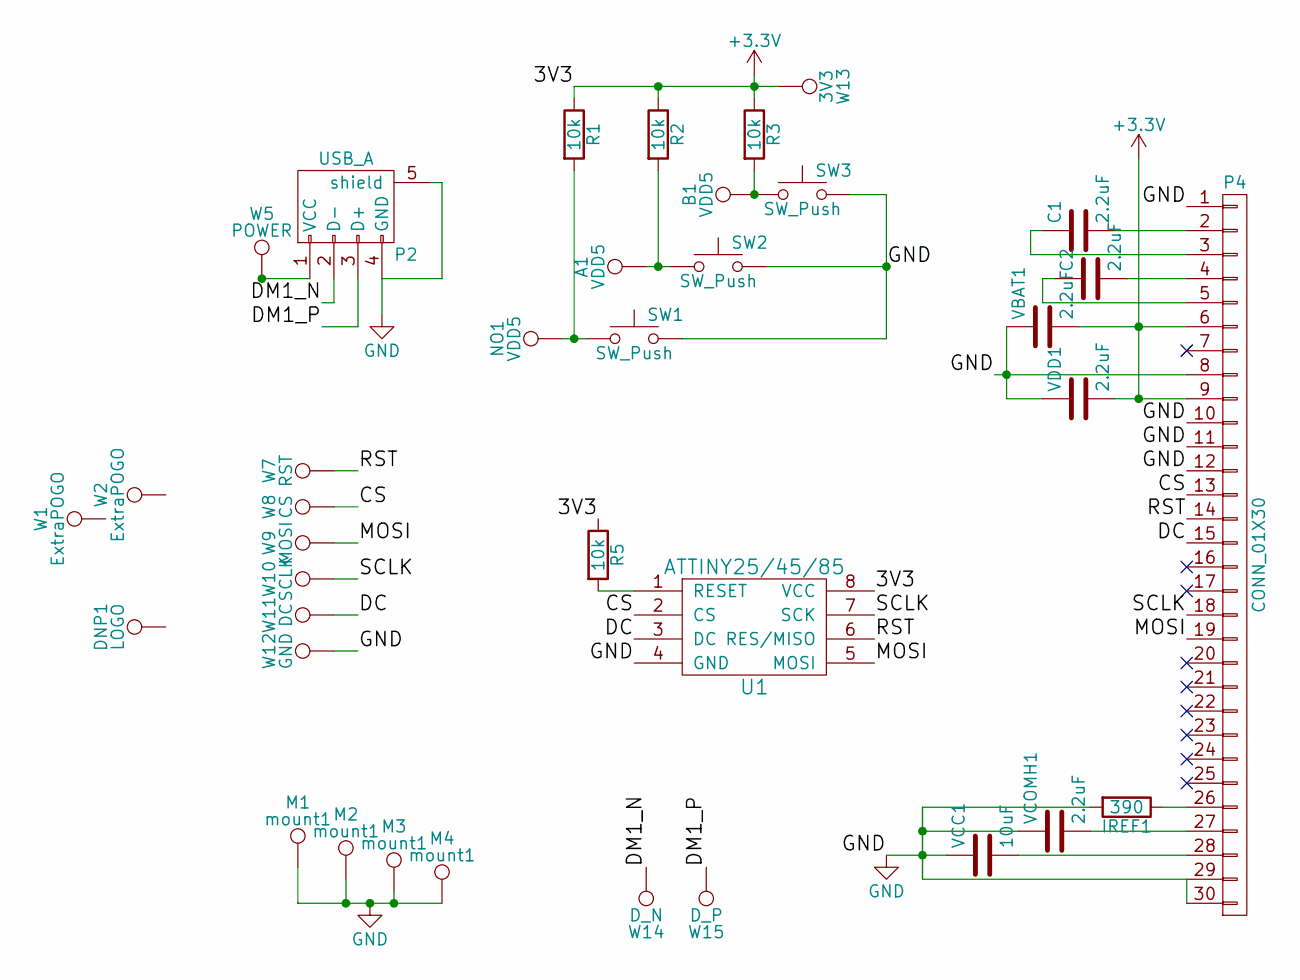
[picture p34: schematic pHAT.sch, pISO]

Parts:
A1: VDD5; SLP
B1: VDD5; SLP
C1, C2: 2.2uF; C_0805
DNP1: LOGO
IREF1: 390; R_0805
M1, M2, M3, M4: mount1; mount
NO1: VDD5; SLP
P2: USB_A; usb
P4: CONN_01X30; FPC_30
R1, R2, R3, R5: 10k; R_0805
SW1, SW2, SW3: SW_Push; spst
U1: ATTINY25/45/85; SOIJ-8_5.3x5.3mm_Pitch1.27mm
VBAT1: 2.2uF; C_0805
VCC1: 10uF; C_0805
VCOMH1: 2.2uF; C_0805
VDD1: 2.2uF; C_0805
W1, W2: ExtraPOGO; SLP
W5: POWER; SLP
W7: RST; SLP
W8: CS; SLP
W9: MOSI; SLP
W10: SCLK; SLP
W11: DC; SLP
W12: GND; SLP
W13: 3V3; SLP
W14: D_N; SLP
W15: D_P; SLP

Connections:
+3V3: P4.6, P4.9, R1.1, R2.1, R3.1, R5.1, U1.8 (VCC), VBAT1.2, VDD1.2, W13.1
/CS: P4.13, U1.2 (CS), W8.1
/DC: P4.15, U1.3 (DC), W11.1
/DM1_N: P2.2 (D-), W14.1
/DM1_P: P2.3 (D+), W15.1
/MOSI: P4.19, U1.5 (MOSI), W9.1
/RST: P4.14, U1.6 (RES/MISO), W7.1
/SCLK: P4.18, U1.7 (SCK), W10.1
GND: IREF1.2, M1.1, M2.1, M3.1, M4.1, P2.4 (GND), P2.5 (shield), P4.1, P4.8, P4.10, P4.11, P4.12, P4.29, P4.30, SW1.2, SW2.2, SW3.2, U1.4 (GND), VBAT1.1, VCC1.1, VCOMH1.1, VDD1.1, W12.1
unnamed: A1.1, R2.2, SW2.1
unnamed: B1.1, R3.2, SW3.1
unnamed: C1.1, P4.3
unnamed: C1.2, P4.2
unnamed: C2.1, P4.5
unnamed: C2.2, P4.4
unnamed: IREF1.1, P4.26
unnamed: NO1.1, R1.2, SW1.1
unnamed: P2.1 (VCC), W5.1
unnamed: P4.27, VCOMH1.2
unnamed: P4.28, VCC1.2
unnamed: R5.2, U1.1 (RESET)

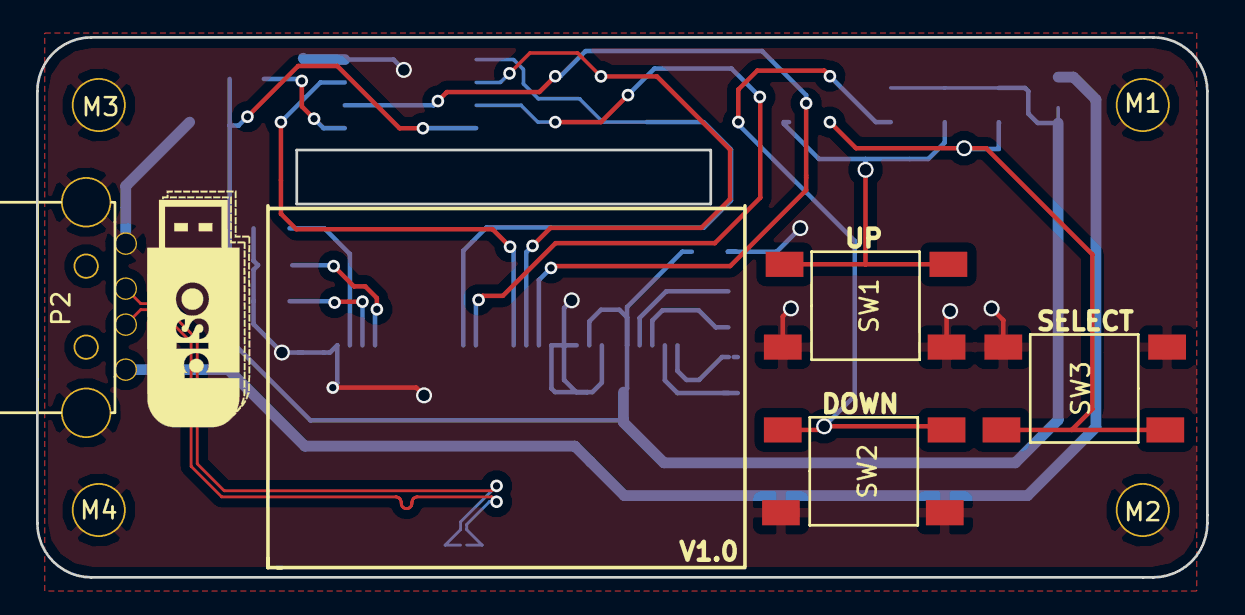
[picture p35: board pHAT.kicad_pcb from above]

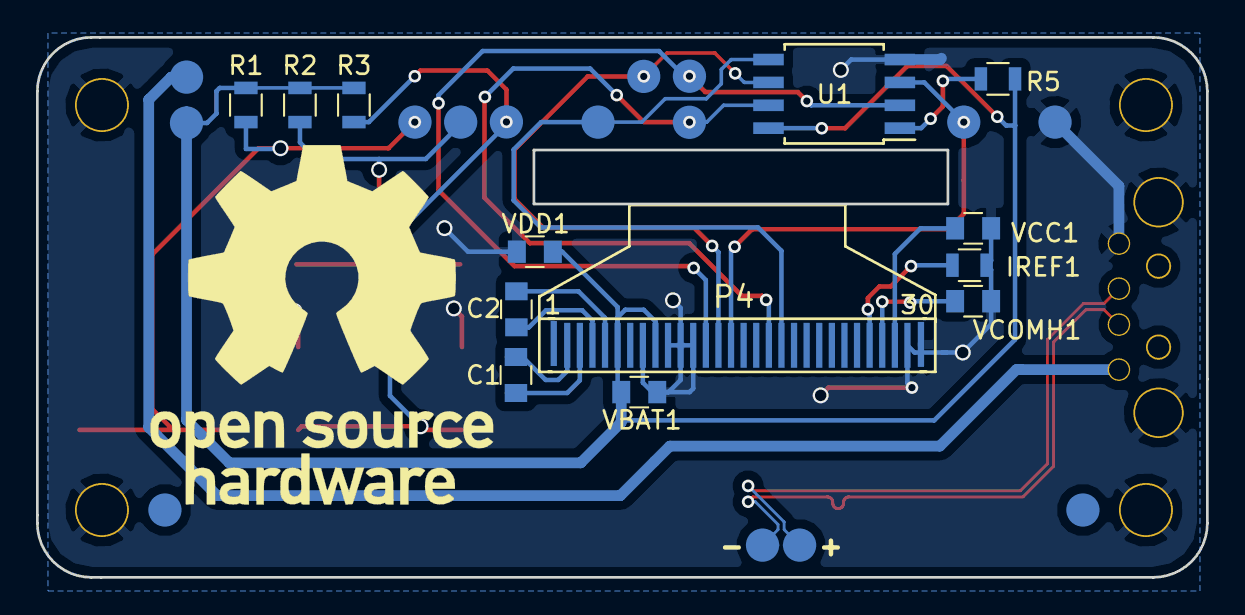
[picture p36: board pHAT.kicad_pcb from below]

Board: 2 copper layers, 65.0 x 30.0 mm, 37 parts (26 on the bottom side), 21 nets.
