ALSchwalm/pISO/pISO/src/main.cpp

#include <cppgpio.hpp>
#include <errno.h>
#include <exception>
#include <string.h>
#include <wiringPi.h>

#include "bitmap.hpp"
#include "controller.hpp"
#include "display.hpp"
#include "font.hpp"
#include "lvmwrapper.hpp"
#include "piso.hpp"

void terminate_handler() {
  // TODO: include a link to the wiki/issue page
  Display::instance().update(render_text("An error occured."));
  std::abort();
}

int main() {
  std::set_terminate(terminate_handler);

  if (wiringPiSetupGpio() == -1) {
    piso_error("Error while setting up GPIO: ", strerror(errno));
  }

  auto &piso = pISO::instance();
  Display::instance().update(piso.render().first);

  auto &controller = Controller::instance();
  controller.on_move = [&](Controller::Direction dir) {
    if (dir == Controller::Direction::UP) {
      piso.on_prev();
    } else {
      piso.on_next();
    }
    Display::instance().update(piso.render().first);
  };
  controller.on_select = [&]() {
    piso.on_select();
    Display::instance().update(piso.render().first);
  };
  controller.on_long_press = [&] {
    Display::instance().update(piso.render().first);
  };
  controller.start();

  while (true) {
    {
      std::lock_guard<std::mutex> lock{controller.lock()};
      Display::instance().update(piso.render().first);
    }
    std::this_thread::sleep_for(std::chrono::seconds(10));
  }
}
