ALSchwalm/pISO/pISO/src/newdrive.rs

use action;
use bitmap;
use config;
use controller;
use displaymanager::{DisplayManager, Position, Widget, Window, WindowId};
use error;
use font;
use input;
use lvm;
use render;
use usb;
use utils;
use state;
use std::sync::{Arc, Mutex};
use std::time::Duration;
use std::path::{Path, PathBuf};

enum NewDriveState {
    Unselected,
    PickingSize(DriveSize),
}

pub struct NewDrive {
    pub window: WindowId,
    pub usb: Arc<Mutex<usb::UsbGadget>>,
    vg: lvm::VolumeGroup,
    state: NewDriveState,
    config: config::Config,
}

impl NewDrive {
    pub fn new(
        disp: &mut DisplayManager,
        usb: Arc<Mutex<usb::UsbGadget>>,
        vg: lvm::VolumeGroup,
        config: config::Config,
    ) -> error::Result<NewDrive> {
        let our_window = disp.add_child(Position::Normal)?;
        Ok(NewDrive {
            window: our_window,
            state: NewDriveState::Unselected,
            usb: usb,
            vg: vg,
            config: config,
        })
    }
}

impl render::Render for NewDrive {
    fn render(&self, _manager: &DisplayManager, window: &Window) -> error::Result<bitmap::Bitmap> {
        let mut base = bitmap::Bitmap::new(10, 1);
        base.blit(
            &bitmap::with_border(font::render_text("New Drive"), bitmap::BorderStyle::Top, 2),
            (12, 0),
        );
        if window.focus {
            base.blit(&bitmap::Bitmap::from_slice(font::ARROW), (0, 3));
        }
        Ok(base)
    }
}

impl input::Input for NewDrive {
    fn on_event(
        &mut self,
        event: &controller::Event,
    ) -> error::Result<(bool, Vec<action::Action>)> {
        match *event {
            controller::Event::Select => Ok((true, vec![action::Action::OpenSizeMenu])),
            _ => Ok((false, vec![])),
        }
    }

    fn do_action(
        &mut self,
        disp: &mut DisplayManager,
        action: &action::Action,
    ) -> error::Result<(bool, Vec<action::Action>)> {
        match *action {
            action::Action::OpenSizeMenu => {
                let menu =
                    DriveSize::new(disp, self.usb.clone(), self.vg.clone(), self.config.clone())?;
                disp.shift_focus(&menu);
                self.state = NewDriveState::PickingSize(menu);
                Ok((true, vec![]))
            }
            action::Action::CloseFormatMenu => {
                disp.shift_focus(self);
                self.state = NewDriveState::Unselected;
                Ok((true, vec![]))
            }
            _ => Ok((false, vec![])),
        }
    }
}

impl state::State for NewDrive {}

impl Widget for NewDrive {
    fn mut_children(&mut self) -> Vec<&mut Widget> {
        match self.state {
            NewDriveState::PickingSize(ref mut widget) => vec![widget],
            NewDriveState::Unselected => vec![],
        }
    }

    fn children(&self) -> Vec<&Widget> {
        match self.state {
            NewDriveState::PickingSize(ref widget) => vec![widget],
            NewDriveState::Unselected => vec![],
        }
    }

    fn windowid(&self) -> WindowId {
        self.window
    }
}

enum DriveSizeState {
    Unselected,
    Selected(DriveFormat),
}

struct DriveSize {
    pub window: WindowId,
    pub current_percent: f32,
    pub usb: Arc<Mutex<usb::UsbGadget>>,
    vg: lvm::VolumeGroup,
    state: DriveSizeState,
    config: config::Config,
}

impl DriveSize {
    fn new(
        disp: &mut DisplayManager,
        usb: Arc<Mutex<usb::UsbGadget>>,
        vg: lvm::VolumeGroup,
        config: config::Config,
    ) -> error::Result<DriveSize> {
        Ok(DriveSize {
            window: disp.add_child(Position::Fixed(0, 0))?,
            current_percent: config.ui.default_size,
            usb: usb,
            vg: vg,
            state: DriveSizeState::Unselected,
            config: config,
        })
    }

    fn current_size(&self) -> u64 {
        let bytes = self.vg.report().expect("Failed to get vg report").vg_size as f32
            * (self.current_percent / 100.0);
        ((bytes as u64 + 512 - 1) / 512) * 512
    }
}

impl render::Render for DriveSize {
    fn render(&self, manager: &DisplayManager, _window: &Window) -> error::Result<bitmap::Bitmap> {
        let mut base = bitmap::Bitmap::new(manager.display.width(), manager.display.height());
        base.blit(&font::render_text("New drive capacity:"), (0, 0));

        let short_size = self.current_size() as f64 / (1024 * 1024 * 1024) as f64;
        base.blit(
            &font::render_text(format!("{}% ({:.2}GB)", self.current_percent, short_size)),
            (10, 30),
        );
        Ok(base)
    }
}

impl input::Input for DriveSize {
    fn on_event(
        &mut self,
        event: &controller::Event,
    ) -> error::Result<(bool, Vec<action::Action>)> {
        match *event {
            controller::Event::Select => Ok((true, vec![action::Action::OpenFormatMenu])),
            controller::Event::Up => Ok((true, vec![action::Action::IncDriveSize])),
            controller::Event::Down => Ok((true, vec![action::Action::DecDriveSize])),
            _ => Ok((false, vec![])),
        }
    }

    fn do_action(
        &mut self,
        disp: &mut DisplayManager,
        action: &action::Action,
    ) -> error::Result<(bool, Vec<action::Action>)> {
        match *action {
            action::Action::IncDriveSize => {
                self.current_percent += self.config.ui.size_step;
                Ok((true, vec![]))
            }
            action::Action::DecDriveSize => {
                if self.current_percent - self.config.ui.size_step > 0.0 {
                    self.current_percent -= self.config.ui.size_step;
                }
                Ok((true, vec![]))
            }
            action::Action::OpenFormatMenu => {
                let menu = DriveFormat::new(
                    disp,
                    self.vg.clone(),
                    self.current_size(),
                    self.config.clone(),
                )?;
                disp.shift_focus(&menu);
                self.state = DriveSizeState::Selected(menu);
                Ok((true, vec![]))
            }
            action::Action::CloseFormatMenu => {
                self.state = DriveSizeState::Unselected;
                Ok((true, vec![]))
            }
            _ => Ok((false, vec![])),
        }
    }
}

impl state::State for DriveSize {}

impl Widget for DriveSize {
    fn mut_children(&mut self) -> Vec<&mut Widget> {
        match self.state {
            DriveSizeState::Selected(ref mut menu) => vec![menu],
            DriveSizeState::Unselected => vec![],
        }
    }

    fn children(&self) -> Vec<&Widget> {
        match self.state {
            DriveSizeState::Selected(ref menu) => vec![menu],
            DriveSizeState::Unselected => vec![],
        }
    }

    fn windowid(&self) -> WindowId {
        self.window
    }
}

enum InitialDriveFormat {
    Windows,
    MacOs,
    Linux,
    Universal,
}

#[derive(PartialEq)]
enum DriveFormatState {
    Selecting,
    Formatting,
    Done,
}

struct DriveFormat {
    pub windowid: WindowId,
    vg: lvm::VolumeGroup,
    size: u64,
    selected: InitialDriveFormat,
    state: DriveFormatState,
    config: config::Config,
}

impl DriveFormat {
    fn new(
        disp: &mut DisplayManager,
        vg: lvm::VolumeGroup,
        size: u64,
        config: config::Config,
    ) -> error::Result<DriveFormat> {
        Ok(DriveFormat {
            windowid: disp.add_child(Position::Fixed(0, 0))?,
            vg: vg,
            size: size,
            selected: InitialDriveFormat::Windows,
            state: DriveFormatState::Selecting,
            config: config,
        })
    }

    fn next_format(&self) -> InitialDriveFormat {
        match self.selected {
            InitialDriveFormat::Windows => InitialDriveFormat::MacOs,
            InitialDriveFormat::MacOs => InitialDriveFormat::Linux,
            InitialDriveFormat::Linux => InitialDriveFormat::Universal,
            InitialDriveFormat::Universal => InitialDriveFormat::Universal,
        }
    }

    fn prev_format(&self) -> InitialDriveFormat {
        match self.selected {
            InitialDriveFormat::Windows => InitialDriveFormat::Windows,
            InitialDriveFormat::MacOs => InitialDriveFormat::Windows,
            InitialDriveFormat::Linux => InitialDriveFormat::MacOs,
            InitialDriveFormat::Universal => InitialDriveFormat::Linux,
        }
    }

    fn format_volume(
        volume: &mut lvm::LogicalVolume,
        format: &InitialDriveFormat,
        name: &str,
    ) -> error::Result<()> {
        // First create the partition table
        match *format {
            InitialDriveFormat::Windows | InitialDriveFormat::MacOs => {
                utils::run_check_output(
                    "parted",
                    &[
                        "--script",
                        &volume.path.to_string_lossy(),
                        "mklabel msdos",
                        "mkpart primary ntfs 0% 100%",
                    ],
                )?;
            }
            InitialDriveFormat::Linux => {
                utils::run_check_output(
                    "parted",
                    &[
                        "--script",
                        &volume.path.to_string_lossy(),
                        "mklabel msdos",
                        "mkpart primary ext3 0% 100%",
                    ],
                )?;
            }
            InitialDriveFormat::Universal => {
                utils::run_check_output(
                    "parted",
                    &[
                        "--script",
                        &volume.path.to_string_lossy(),
                        "mklabel msdos",
                        "mkpart primary fat32 0% 100%",
                    ],
                )?;
            }
        };

        let volume_path = &volume.path.to_string_lossy();
        let loopback_path =
            PathBuf::from(utils::run_check_output("losetup", &["-f"])?.trim_right());

        utils::run_check_output("losetup", &["-fPL", volume_path])?;
        utils::wait_for_path(&loopback_path, Duration::from_millis(1000))?;
        utils::run_check_output("partprobe", &[&loopback_path])?;

        let first_part_path: String = (loopback_path.to_string_lossy() + "p1").into_owned();
        utils::wait_for_path(&Path::new(&first_part_path), Duration::from_millis(1000))?;

        // Now do the format
        match *format {
            InitialDriveFormat::Windows => {
                utils::run_check_output("mkfs.ntfs", &["-f", &first_part_path])?;
                utils::run_check_output("ntfslabel", &[&first_part_path, name])?;
            }
            InitialDriveFormat::MacOs => {
                utils::run_check_output("mkfs.exfat", &[&first_part_path])?;
                utils::run_check_output("exfatlabel", &[&first_part_path, name])?;
            }
            InitialDriveFormat::Linux => {
                utils::run_check_output("mkfs.ext3", &[&first_part_path])?;
                utils::run_check_output("e2label", &[&first_part_path, name])?;
            }
            InitialDriveFormat::Universal => {
                utils::run_check_output("mkfs.msdos", &["-F", "32", "-I", &first_part_path])?;
                utils::run_check_output("dosfslabel", &[&first_part_path, name])?;
            }
        };

        utils::run_check_output("losetup", &["-d", &loopback_path.to_string_lossy()])?;
        Ok(())
    }
}

impl render::Render for DriveFormat {
    fn render(&self, manager: &DisplayManager, _window: &Window) -> error::Result<bitmap::Bitmap> {
        let mut base = bitmap::Bitmap::new(manager.display.width(), manager.display.height());

        if self.state != DriveFormatState::Selecting {
            base.blit(&font::render_text("Formatting new drive"), (0, 0));
            return Ok(base);
        }

        base.blit(&font::render_text("Select Format:"), (0, 0));

        base.blit(&font::render_text("Windows (NTFS)"), (10, 9));
        base.blit(&font::render_text("MacOS (EXFAT)"), (10, 9 * 2));
        base.blit(&font::render_text("Linux (EXT3)"), (10, 9 * 3));
        base.blit(&font::render_text("Universal (FAT32)"), (10, 9 * 4));

        let pos = match self.selected {
            InitialDriveFormat::Windows => (2, 9),
            InitialDriveFormat::MacOs => (2, 9 * 2),
            InitialDriveFormat::Linux => (2, 9 * 3),
            InitialDriveFormat::Universal => (2, 9 * 4),
        };
        base.blit(&bitmap::Bitmap::from_slice(font::ARROW), pos);

        Ok(base)
    }
}

impl input::Input for DriveFormat {
    fn on_event(
        &mut self,
        event: &controller::Event,
    ) -> error::Result<(bool, Vec<action::Action>)> {
        match *event {
            controller::Event::Select => Ok((true, vec![action::Action::FormatDrive])),
            controller::Event::Up => {
                self.selected = self.prev_format();
                Ok((true, vec![]))
            }
            controller::Event::Down => {
                self.selected = self.next_format();
                Ok((true, vec![]))
            }
            _ => (Ok((false, vec![]))),
        }
    }

    fn do_action(
        &mut self,
        _disp: &mut DisplayManager,
        action: &action::Action,
    ) -> error::Result<(bool, Vec<action::Action>)> {
        match *action {
            action::Action::FormatDrive => match self.state {
                DriveFormatState::Selecting => {
                    self.state = DriveFormatState::Formatting;
                    return Ok((false, vec![]));
                }
                _ => {
                    let name = utils::next_available_drive_name(&self.vg)?;
                    let mut volume = self.vg.create_volume(&name, self.size)?;

                    let part_name = utils::translate_drive_name(&name, &self.config);

                    DriveFormat::format_volume(&mut volume, &self.selected, &part_name)?;

                    self.state = DriveFormatState::Done;
                    return Ok((
                        true,
                        vec![
                            action::Action::CloseFormatMenu,
                            action::Action::CreateDrive(volume),
                        ],
                    ));
                }
            },
            _ => Ok((false, vec![])),
        }
    }
}

impl state::State for DriveFormat {}

impl Widget for DriveFormat {
    fn windowid(&self) -> WindowId {
        self.windowid
    }
}
