ALSchwalm/pISO/pISO/src/virtualdrive.cpp

#include "virtualdrive.hpp"
#include "config.hpp"
#include "error.hpp"
#include "font.hpp"
#include <errno.h>
#include <sys/stat.h>
#include <sys/types.h>

bool VirtualDriveHeading::on_select() {
  piso_log("VirtualDriveHeading::on_select()");
  switch (m_vdrive.mount_state()) {
  case VirtualDrive::MountState::UNMOUNTED:
    m_vdrive.mount_external();
    break;
  case VirtualDrive::MountState::EXTERNAL:
    m_vdrive.unmount_external();
    m_vdrive.mount_internal();
    break;
  case VirtualDrive::MountState::INTERNAL:
    m_vdrive.unmount_internal();
    m_vdrive.mount_external();
    break;
  }
  return true;
}

std::pair<Bitmap, GUIRenderable::RenderMode>
VirtualDriveHeading::render() const {
  piso_log("VirtualDriveHeading::render()");
  auto text = render_text(m_vdrive.name());

  Bitmap indented(text.width() + MENU_INDENT, text.height());
  indented.blit(text, {MENU_INDENT, 0});
  if (m_vdrive.mount_state() == VirtualDrive::MountState::EXTERNAL) {
    indented.blit(mount_indicator, {selector.width(), 0});
  }
  if (m_focused) {
    indented.blit(selector, {0, 0});
    return {indented, GUIRenderable::RenderMode::NORMAL};
  } else {
    return {indented, GUIRenderable::RenderMode::NORMAL};
  }
}

VirtualDrive::VirtualDrive(const std::string &volume_name)
    : m_volume_name{volume_name}, m_heading{*this} {
  m_uuid = lvm_lvs_volume_value("lv_uuid", volume_name);
  auto sizestr =
      lvm_lvs_report("lv_size --units B", volume_name)["lv_size"].asString();
  m_size = std::stoull(sizestr);
  update_list_items();
}

VirtualDrive::VirtualDrive(VirtualDrive &&other)
    : m_volume_name{other.m_volume_name}, m_uuid{other.m_uuid},
      m_size{other.m_size}, m_isos{other.m_isos},
      m_mount_state{other.m_mount_state}, m_heading{*this} {
  update_list_items();
}

VirtualDrive &VirtualDrive::operator=(VirtualDrive &&other) {
  m_volume_name = std::move(other.m_volume_name);
  m_uuid = std::move(other.m_uuid);
  m_size = std::move(other.m_size);
  m_isos = std::move(other.m_isos);
  m_mount_state = std::move(other.m_mount_state);

  update_list_items();
  return *this;
}

bool VirtualDrive::mount_internal() {
  piso_log("VirtualDrive::mount_internal()");

  if (m_mount_state != MountState::UNMOUNTED) {
    piso_log("Drive is not unmounted");
    return false;
  }

  auto base_mount = config_getenv("PISO_BASE_MOUNT");
  auto path = base_mount + "/" + name();
  if (mkdir(path.c_str(), 0777) == -1 && errno != EEXIST) {
    piso_error("Cannot create path: ", path);
  }

  auto scripts_path = config_getenv("PISO_SCRIPTS_PATH");
  auto vdrive_script = scripts_path + "/vdrive.sh";

  auto mount_res =
      run_command("sh ", vdrive_script, " mount-internal ", name(), " ", path);
  piso_log("mount-internal returned: ", mount_res);

  std::istringstream isostream{mount_res};
  std::string iso_path;
  for (unsigned int i = 0; std::getline(isostream, iso_path, '\n'); ++i) {
    m_isos.emplace_back(iso_path, name() + std::to_string(i));
  }

  update_list_items();
  m_mount_state = MountState::INTERNAL;
  return true;
}

bool VirtualDrive::unmount_internal() {
  piso_log("VirtualDrive::unmount_internal()");

  if (m_mount_state != MountState::INTERNAL) {
    piso_log("Drive is not mounted internal");
    return false;
  }

  for (auto &iso : m_isos) {
    if (iso.is_mounted()) {
      iso.unmount();
    }
  }

  auto base_mount = config_getenv("PISO_BASE_MOUNT");
  auto path = base_mount + "/" + name();

  auto scripts_path = config_getenv("PISO_SCRIPTS_PATH");
  auto vdrive_script = scripts_path + "/vdrive.sh";

  run_command("sh ", vdrive_script, " unmount-internal ", path);

  m_isos.clear();

  update_list_items();
  m_mount_state = MountState::UNMOUNTED;
  return true;
}

bool VirtualDrive::mount_external() {
  piso_log("VirtualDrive::mount_external()");

  if (m_mount_state != MountState::UNMOUNTED) {
    piso_log("Drive is mounted");
    return false;
  }

  auto scripts_path = config_getenv("PISO_SCRIPTS_PATH");
  auto vdrive_script = scripts_path + "/vdrive.sh";

  run_command("sh ", vdrive_script, " mount-external ", name());
  update_list_items();
  m_mount_state = MountState::EXTERNAL;
  return true;
}

bool VirtualDrive::unmount_external() {
  piso_log("VirtualDrive::unmount_external()");

  if (m_mount_state != MountState::EXTERNAL) {
    piso_log("Drive is not mounted external");
    return false;
  }

  auto scripts_path = config_getenv("PISO_SCRIPTS_PATH");
  auto vdrive_script = scripts_path + "/vdrive.sh";

  run_command("sh ", vdrive_script, " unmount-external ", name());
  update_list_items();
  m_mount_state = MountState::UNMOUNTED;
  return true;
}

void VirtualDrive::update_list_items() {
  piso_log("VirtualDrive: Updating menu items");
  m_list_items.clear();
  m_list_items.push_back(&m_heading);
  for (auto &iso : m_isos) {
    m_list_items.push_back(&iso);
  }
  for (const auto &item : m_list_items) {
    item->on_lose_focus();
  }
  m_selection = m_list_items.begin();
  if (has_selection()) { // FIXME: only do this if something lost focus?
    (*m_selection)->on_focus();
  }
}

float VirtualDrive::percent_used() const {
  return std::stof(lvm_lvs_volume_value("data_percent", m_volume_name));
}

bool VirtualDrive::on_focus() {
  piso_log("VirtualDrive::on_focus()");
  return GUIListItem::on_focus();
}

bool VirtualDrive::on_lose_focus() {
  piso_log("VirtualDrive::on_lose_focus()");
  return GUIListItem::on_lose_focus();
}

bool VirtualDrive::on_select() {
  piso_log("VirtualDrive::on_select()");
  return GUIListItem::on_select();
}

bool VirtualDrive::on_next() {
  piso_log("VirtualDrive::on_next()");
  return GUIListItem::on_next();
}

bool VirtualDrive::on_prev() {
  piso_log("VirtualDrive::on_prev()");
  return GUIListItem::on_prev();
}

std::pair<Bitmap, GUIRenderable::RenderMode> VirtualDrive::render() const {
  piso_log("VirtualDrive::render()");
  auto bitmap = m_heading.render().first;
  for (const auto &iso : m_isos) {
    auto iso_bitmap = iso.render().first;
    auto old_height = bitmap.height();
    bitmap.expand_height(iso_bitmap.height());
    if (iso_bitmap.width() + ISO_LABEL_INDENT > bitmap.width()) {
      bitmap.expand_width(iso_bitmap.width() - bitmap.width() +
                          ISO_LABEL_INDENT);
    }
    bitmap.blit(iso_bitmap, {ISO_LABEL_INDENT, old_height});
  }
  return {bitmap, GUIRenderable::RenderMode::NORMAL};
}
