ALSchwalm/pISO/pISO/src/font.rs

use bitmap::Bitmap;

pub fn render_text<S>(text: S) -> Bitmap
where
    S: AsRef<str>,
{
    let mut text_map = Bitmap::new(0, 0);
    for letter in text.as_ref().bytes() {
        let letter_map = if letter > FONT.len() as u8 {
            UNPRINTABLE
        } else {
            FONT[letter as usize]
        };
        let current_width = text_map.width();
        text_map.blit(&Bitmap::from_slice(letter_map), (current_width, 0));

        // Add a 1 pixel space between the letters
        let current_width = text_map.width();
        text_map.set_width(current_width + 1);
    }
    text_map
}

macro_rules! font_char {
    (
        $(
            {
                $( $bit:expr ),*
            }
        ),*
    ) => {
        &[$(&[$( $bit),*]),*]
    }
}

macro_rules! font_rule {
    (
        $name:ident
    ) => {
        $name
    };

    (
        $contents:tt
    ) => {
        font_char! $contents
    }
}

macro_rules! font {
    (
        $(
            $name:expr => $contents:tt
        ),*
    ) => {
        [
            $(font_rule!($contents)),*
        ]
    }
}

const UNPRINTABLE: &'static [&[u8]] = font_char!{
    {1, 1, 1, 1},
    {1, 0, 0, 1},
    {1, 0, 0, 1},
    {1, 0, 0, 1},
    {1, 0, 0, 1},
    {1, 0, 0, 1},
    {1, 0, 0, 1},
    {1, 0, 0, 1},
    {1, 1, 1, 1}
};

pub const ARROW: &'static [&[u8]] = font_char!{
    {0, 0, 0, 0, 0, 0},
    {0, 0, 0, 0, 0, 0},
    {0, 0, 1, 0, 0, 0},
    {0, 0, 0, 1, 0, 0},
    {1, 1, 1, 1, 1, 0},
    {0, 0, 0, 1, 0, 0},
    {0, 0, 1, 0, 0, 0},
    {0, 0, 0, 0, 0, 0},
    {0, 0, 0, 0, 0, 0}
};

pub const SQUARE: &'static [&[u8]] = font_char!{
    {0, 0, 0, 0, 0},
    {0, 0, 0, 0, 0},
    {0, 1, 1, 1, 0},
    {0, 1, 1, 1, 0},
    {0, 1, 1, 1, 0},
    {0, 1, 1, 1, 0},
    {0, 0, 0, 0, 0},
    {0, 0, 0, 0, 0},
    {0, 0, 0, 0, 0}
};

const FONT: [&[&[u8]]; 128] = font!{
    // The first 32 unprintable characters
    "NUL" => UNPRINTABLE,
    "SOH" => UNPRINTABLE,
    "STX" => UNPRINTABLE,
    "ETX" => UNPRINTABLE,
    "EOT" => UNPRINTABLE,
    "ENQ" => UNPRINTABLE,
    "ACK" => UNPRINTABLE,
    "BEL" => UNPRINTABLE,
    "BS"  => UNPRINTABLE,
    "HT"  => UNPRINTABLE,
    "LF"  => UNPRINTABLE,
    "VT"  => UNPRINTABLE,
    "FF"  => UNPRINTABLE,
    "CR"  => UNPRINTABLE,
    "SO"  => UNPRINTABLE,
    "SI"  => UNPRINTABLE,
    "DLE" => UNPRINTABLE,
    "DC1" => UNPRINTABLE,
    "DC2" => UNPRINTABLE,
    "DC3" => UNPRINTABLE,
    "DC4" => UNPRINTABLE,
    "NAK" => UNPRINTABLE,
    "SYN" => UNPRINTABLE,
    "ETB" => UNPRINTABLE,
    "CAN" => UNPRINTABLE,
    "EM"  => UNPRINTABLE,
    "SUB" => UNPRINTABLE,
    "ESC" => UNPRINTABLE,
    "FS"  => UNPRINTABLE,
    "GS"  => UNPRINTABLE,
    "RS"  => UNPRINTABLE,
    "US"  => UNPRINTABLE,

    " " => {
        {0, 0},
        {0, 0},
        {0, 0},
        {0, 0},
        {0, 0},
        {0, 0},
        {0, 0},
        {0, 0},
        {0, 0}
    },

    "!" => {
        {0},
        {1},
        {1},
        {1},
        {1},
        {0},
        {1},
        {0},
        {0}
    },

    "\"" => {
        {0, 0, 0},
        {1, 0, 1},
        {1, 0, 1},
        {0, 0, 0},
        {0, 0, 0},
        {0, 0, 0},
        {0, 0, 0},
        {0, 0, 0},
        {0, 0, 0}
    },

    "#" => {
        {0, 1, 0, 1, 0},
        {0, 1, 0, 1, 0},
        {1, 1, 1, 1, 1},
        {0, 1, 0, 1, 0},
        {1, 1, 1, 1, 1},
        {0, 1, 0, 1, 0},
        {0, 1, 0, 1, 0},
        {0, 0, 0, 0, 0},
        {0, 0, 0, 0, 0}
    },

    "$" => {
        {0, 0, 1, 0, 0},
        {0, 1, 1, 1, 0},
        {1, 0, 1, 0, 1},
        {1, 0, 1, 0, 0},
        {0, 1, 1, 1, 0},
        {0, 0, 1, 0, 1},
        {1, 0, 1, 0, 1},
        {0, 1, 1, 1, 0},
        {0, 0, 1, 0, 0}
    },

    "%" => {
        {0, 1, 0, 0, 0, 0},
        {1, 0, 1, 0, 1, 0},
        {0, 1, 0, 0, 1, 0},
        {0, 0, 0, 1, 0, 0},
        {0, 0, 1, 0, 0, 0},
        {0, 1, 0, 0, 1, 0},
        {0, 1, 0, 1, 0, 1},
        {0, 0, 0, 0, 1, 0},
        {0, 0, 0, 0, 0, 0}
    },

    "&" => {
        {0, 1, 1, 0, 0},
        {1, 0, 0, 1, 0},
        {1, 0, 0, 1, 0},
        {0, 1, 1, 0, 0},
        {1, 0, 0, 1, 1},
        {1, 0, 0, 1, 0},
        {0, 1, 1, 0, 1},
        {0, 0, 0, 0, 0},
        {0, 0, 0, 0, 0}
    },

    "'" => {
        {0},
        {1},
        {1},
        {0},
        {0},
        {0},
        {0},
        {0},
        {0}
    },

    "(" => {
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
        {0, 0, 0},
        {0, 0, 0}
    },

    "~" => {
        {0, 0, 0, 0},
        {0, 0, 0, 0},
        {0, 1, 0, 1},
        {1, 0, 1, 0},
        {0, 0, 0, 0},
        {0, 0, 0, 0},
        {0, 0, 0, 0},
        {0, 0, 0, 0},
        {0, 0, 0, 0}
    },

    "DEL"  => UNPRINTABLE
};
