ALSchwalm/pISO/(commit log)

2017-08-27 Add usb startup script
    [board.brd, board.sch]
2017-08-27 Add buildroot configs
    [genimage-raspberrypi0.cfg]
2017-10-22 Add buildroot as submodule
    [genimage-raspberrypi0.cfg]
2017-10-25 Fix bug where base mount path was not string
    [virtualdrive.cpp]
2017-10-26 Start switching to using cli over lvm2app
2017-11-12 Add better rotary encoder
2017-11-17 Bug fixes for screen/controller
    [controller.hpp, display.cpp, main.cpp, piso.cpp, piso.hpp, virtualdrive.cpp, virtualdrive.hpp]
2017-11-20 Fix flash on lcd during startup
    [main.cpp, piso.cpp]
2017-12-03 Fix pins for new board and add mount indicator
    [config.hpp, controller.cpp, controller.hpp, iso.cpp, main.cpp, piso.cpp, virtualdrive.cpp]
2017-12-04 adding current KiCad files, need to update Gerbers
    [pHAT-B.Cu.gbl, pHAT-B.Mask.gbs, pHAT-B.Paste.gbp, pHAT-B.SilkS.gbo, pHAT-Edge.Cuts.gm1, pHAT-F.Cu.gtl, pHAT-F.Mask.gts, pHAT-F.Paste.gtp]
2017-12-09 PCB layout with buttons
    [pHAT-B.Cu.gbl, pHAT-B.Mask.gbs, pHAT-B.Paste.gbp, pHAT-B.SilkS.gbo, pHAT-Edge.Cuts.gm1, pHAT-F.Cu.gtl, pHAT-F.Mask.gts, pHAT-F.Paste.gtp]
2017-12-11 Switch back to using sh based setup (seems more reliable)
2017-12-29 Remove rotary encoder
2018-01-21 Add error display message and create partition table for new drives
    [controller.hpp, main.cpp, piso.cpp]
2018-01-21 Fix bug where isos with long names could not be mounted
    [iso.cpp, iso.hpp, virtualdrive.cpp]
2018-01-22 Fix race condition that could case call to pure virtual function
    [controller.hpp, main.cpp]
2018-01-28 Long press select to flip screen
    [controller.cpp, controller.hpp, display.cpp, display.hpp, main.cpp]
2018-03-22 update for USBA board
    [pHAT-B.Cu.gbl, pHAT-B.Mask.gbs, pHAT-B.Paste.gbp, pHAT-B.SilkS.gbo, pHAT-Edge.Cuts.gm1, pHAT-F.Cu.gtl, pHAT-F.Mask.gts, pHAT-F.Paste.gtp]
2018-04-06 Fixup buildroot for rust
    [controller.rs]
2018-04-06 Continue switch to rust
2018-04-06 Fix bug where windows were render in the order they were added rather than the order of .children()
    [displaymanager.rs, input.rs, newdrive.rs, piso.rs, vdrive.rs]
2018-04-06 Toggle external mount on vdrive click
2018-04-07 Fix bug where some lvm reports would not deserialize correctly
    [lvm.rs]
2018-04-07 update PCB for 1.2 support
    [pHAT-B.Cu.gbl, pHAT-B.Mask.gbs, pHAT-B.Paste.gbp, pHAT-B.SilkS.gbo, pHAT-Edge.Cuts.gm1, pHAT-F.Cu.gtl, pHAT-F.Mask.gts, pHAT-F.Paste.gtp]
2018-04-15 update PCB images
    [pHAT.kicad_pcb, pHAT.sch, pHAT.xls]
2018-04-29 Add generic back button
2018-04-29 Add 'Activate Ap' button and back button for wifi
2018-05-04 Render fixed position windows correctly
    [display.rs, displaymanager.rs, iso.rs, newdrive.rs, piso.rs, render.rs, stats.rs]
2018-05-04 Fix bug where storage info was not shown in sub menus
    [displaymanager.rs]
2018-05-04 Fix alignment of arrow on newdrive
    [newdrive.rs]
2018-05-05 Add ability to switch between host and client wifi
2018-05-08 Add usb vendor id/product id
    Allocated from http://http://pid.codes/ see http://pid.codes/1209/0256/
2018-05-11 fixed issue that could cause CS line to short to up button
    [pHAT-B.Cu.gbl, pHAT-B.Mask.gbs, pHAT-B.Paste.gbp, pHAT-B.SilkS.gbo, pHAT-Edge.Cuts.gm1, pHAT-F.Cu.gtl, pHAT-F.Mask.gts, pHAT-F.Paste.gtp]
2018-05-22 Fix bug where vdrive could not be remounted correctly
    [vdrive.rs]
2018-05-23 Fix bug with bitmaps larger than the display size
    [display.rs]
2018-05-26 Make buildroot board scripts executable in ci
2018-06-13 Fix bug where child windows were not always focused or positioned correctly
    [displaymanager.rs]
2018-06-14 Add delete drive option
    Note: there is a known bug where you can not delete a drive that you
    created without a powercycle between.
    [action.rs, lvm.rs, newdrive.rs, piso.rs, vdrive.rs]
2018-06-15 Add basic snapshot support
    This implements most of #4, but doesn't address the concern about corruption
    there.
    [action.rs, lvm.rs, piso.rs]
2018-06-17 Add debug tar file and message on error
    [main.rs]
2018-06-27 Use bindfs to avoid permission problems with user filesystems
    [piso.rs]
2018-06-27 Mount internal into folders with the same names as the vdrives
2018-09-01 Add assets for store/mount iso wiki page
2018-09-02 Create /usr-mnt bindfs mountpoint at startup
    Also make bindfs run in multithreaded mode
2018-09-02 Add link to 'piso.support' on error screen
    [main.rs]
2018-09-03 Fix bug where text from main menu was visible during drive creation
    [newdrive.rs]
2018-09-15 Fix race with user creation
    The volume mount point was created async, so automounted volumes could race
    [piso.rs, wifi.rs]
2018-09-15 Fixed "Optons" menu typo
    [options.rs]
2018-09-16 Fix bug where ntfs partition was not mounted internal
    [vdrive.rs]
2018-09-18 Add a way to flip the display
    [action.rs, config.rs, controller.rs, main.rs, newdrive.rs, piso.rs]
2018-09-21 Add assets for assembly-without-cover section of wiki
2018-09-23 Universal Format (FAT32) needs to be partition type 0x0c to be mountable on MacOS
2018-10-02 Fixed a bug where drive names were calculated badly
    This could result in situations where for example there was a single drive
    named 'Drive2'. The user can then not create any more drives because the
    nexts drive name would be 'Drive2' (because the calculation is just drive
    count + 1). Now we just look for the first available name
    [newdrive.rs, utils.rs]
2018-10-04 Add support for renaming drives
    This adds a new config option '[[drive]]' that currently has a
    'name' and 'newname' field. If a drive would be created that has
    the name 'name' (e.g., Drive1), then it will be shown with the
    new name instead. This will also change the names given to the
    default partition when creating a new drive. It will not change
    the partition name for an already existing drive (though it will
    change the way the names are shown on the pISO itself).
    This will also not work with multiple levels of snapshot. So
    if 'Drive1' is renamed to 'Pictures' and backed up twice, then
    the pISO will show 'Drive1-backup-backup'. If this becomes a
    problem, it shouldn't be too difficult to f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
    [config.rs, newdrive.rs, options.rs, piso.rs, utils.rs, vdrive.rs]
2018-10-05 Fix bug where internal drive names were visible over wifi
    [vdrive.rs]
2018-10-10 Update buildroot with new kernel for DVD support
    Previously, exporting an ISO larger than 2GB would silently truncate
    the file. On some systems, the file could still mount but others
    would detect a corrupt filesystem or mount but fail later. Now the
    max ISO size is about 80GB.
2018-10-10 Switch to 'update.zip' for updates
    This avoids some updates only needing an updated rootfs, while
    others require a kernel and initramfs update as well. Now, the
    user just needs to extract this update.zip file to the root of
    their SD card.
2018-10-10 Update to kernel with READ TRACK INFO support
2018-10-10 Fix bug with READ TRACk INFO
2018-10-11 Increase USB MaxPower to 500mA
2018-10-12 Do not show 'plugged in' drives over network (fixes #49)
    [vdrive.rs]
2018-10-14 Add version menu (fixes #36)
    [action.rs, options.rs, version.rs]
2018-10-14 Use separate smb shares for each partition (fixes #42)
    [action.rs, options.rs, piso.rs, vdrive.rs, version.rs, wifi.rs]
2018-11-08 Fix bug where discs would not mount is MacOS (fixes #32)
    This was caused by MacOS issuing a READ DVD STRUCTURE command to determine
    the type of disc being read. When we failed to respond to this, the OS
    starts to attempt to read with CD READ requests instead of standard READ
    requests. We don't support CD READ currently. Now we respond to the first
    request correctly, so MacOS does normal READs and things work correctly.
2018-11-08 Add support for sorting drives by name (fixes #59)
    [config.rs, piso.rs]
2018-11-08 Allow step_size and default_size to be floats (fixes #57)
    [config.rs, newdrive.rs]
2018-11-08 Prevent underflow of new drive percent (fixes #74)
    [newdrive.rs]
2018-11-08 Fix bug where non W Raspberry Pi Zeros would hang after driver creation (fixes #66)
    [piso.rs]
2018-11-08 Fix bug where usage could be too precise
    [stats.rs]
2018-11-08 Fix bug where ftp users could write to root
    [piso.rs, vdrive.rs]
